fclaudiu19/industrial-gearbox-design/Docs/Glosar relatii OMll.pdf

(1 - acest glosar nu conţine relaţiile de calcul elementare.

GLOSAR

RELAŢII de CALCUL OM II⁽¹

Relaţia | Semnificaţie
mn (z1+ z2) a = 2 cos β | Distanţa dintre axe de referinţă în plan frontal
mn (z1+z2) cos α aw = 2 cos β cos αw | Distanţa dintre axe reală în plan frontal
√da1 2 +√da1 2 −db1 2 −db1 2 −2 aw sin αw εα = 2 π mn cos α | Gardul de acoperire al unui angrenaj cilindric
| Relaţii de calcul a forţelor din angrenajul cilindric cu dantură dreaptă
| Tensiunea maximă normală de contact
1 1 1 1 1 = = ± ± ρ ρ1 ρ2 D1⁄2 D2⁄2 | Curbura redusă
| Factorul de elasticitate
ZN = √ NBH 6 NL | Factorul ciclurilor de solicitare la contact
| Relaţii de calcul a tensiunii maxime de contact din angrenajul cilindric cu dantură dreaptă
| Relaţii de dimensionare a angrenajului cilindric cu dantură dreaptă din condiţia de rezistenţă la contact

Fn =

Ft
cos ∝w

=

2 T1
dw1cos ∝w

| Tensiunile admisibile la contact pentru pinion, respectiv, roată
| Relaţii de calcul a tensiunilor maxime de încovoiere pentru pinion, respectiv, roata angrenajului cilindric cu dantură dreaptă
| Relaţii de dimensionare a angrenajului cilindric cu dantură dreaptă din condiţia de rezistenţă la încovoiere
| Tensiunile admisibile la încovoiere pentru pinion, respectiv, roată
mn = mt cosβ | Dependenţa dintre modulul normal şi cel frontal al unei roţi cilindrice cu dantură înclinată
| Relaţii de calcul a forţelor din angrenajul cilindric cu dantură înclinată
tg αwt = tgαwn/cosβw | Dependenţa dintre unghiul de angrenare în plan frontal şi cel în plan normal al unei roţi cilindrice cu dantură înclinată
Zβ = √cos β | Factorul înclinării danturii pentru solicitarea de contact
| Relaţii de calcul a tensiunii maxime de contact din angrenajul cilindric cu dantură înclinată

Relaţii de dimensionare a angrenajului cilindric cu dantură înclinată din condiţia de rezistenţă la contact

Relaţii de calcul a tensiunilor maxime de încovoiere pentru pinion, respectiv, roata angrenajului cilindric cu dantură înclinată

Relaţii de dimensionare a angrenajului cilindric cu dantură înclinată din condiţia de rezistenţă la încovoiere

Expresia factorului sintetic din relaţiile de mai sus

Parametri geometrici ai roţilor şi angrenajului conic

Raportul de angrenare al angrenajului conic

Forţe în angrenajul conic ortogonal

Relaţii de calcul a tensiunii maxime de contact din angrenajele conice

Relaţii de dimensionare a angrenajelor conice din condiţia de rezistenţă la contact

Relaţii de calcul a tensiunilor maxime de încovoiere din roţile angrenajelor conice

Relaţii de dimensionare a angrenajelor conice din condiţia de rezistenţă la încovoiere

Momentul de torsiune la roata angrenajului hipoid

Raportul de angrenare al angrenajului melcat

Unghiul elicei melcului

Diametrul de divizare al melcului

Forţe în angrenajul melcat

Randamentul angrenajului melcat

Unghiul de frecare redus din angrenajul melcat

Momentul de încovoiere rezultant în secţiunea X

Tensiunea de torsiune secţiunea X

Tensiunea de încovoiere în secţiunea X

Tensiunea echivalentă în secţiunea X (σcX deseori se neglijează)

Tensiunea echivalentă în secţiunea X (torsiune şi încovoiere)

Relaţia de verificare la solicitări compuse (torsiune şi încovoiere)

Momentul echivalent în secţiunea X

Sarcina dinamică echivalentă din rulmenţi

Sarcina dinamică echivalentă medie pentru rulmenţii încărcaţi cu sarcini variabile

Turaţia echivalentă medie a rulmenţilor încărcaţi cu turaţii şi sarcini variabile

Relaţia de calcul a rulmenţilor

Volumul de material rezultat prin uzare

Relaţii de verificare la uzare şi, respectiv, la încălzire a lagărelor cu alunecare cu frecare uscată

Tensiunea de încovoiere din fusul de cap al unui lagăr de alunecare

Ecuaţia de bilanţ termic al unui lagăr cu alunecare cu frecare uscată

Ecuaţia de echilibru a forţelor în direcţie axială din lagărul cu alunecare axial în cazul ipotezei presiunii neuniforme

Ecuaţia de echilibru a forţelor în direcţie axială din lagărul cu alunecare radial în regimul de frecare fluidă

Presiunea medie convenţională din lagărul cu alunecare în regimul cu frecare fluidă

Momentul de frecare din lagărul cu alunecare în regimul cu frecare fluidă

Ecuaţia de bilanţ termic al unui lagăr cu alunecare în regimul cu frecare fluidă

Relaţii de calcul a geometriei transmisiilor prin curele

Forţa utilă transmisă de curea

Relaţii de calcul a forţelor din ramurile unei curele

Forţa din curea generată de forţa centrifugă

Relaţia lui Euler asociată transmisiilor prin curele luând în considerare efectul forţei centrifuge

Coeficientul de frecare redus din transmisiile prin curele trapezoidale

Tensiunea de încovoiere din curea la înfăşurarea pe roţi

Forţa care încarcă arborii transmisiei prin curele

Relaţii de calcul a coeficientului de alunecare elastică

Raportul de transmitere al transmisiei prin curele considerând alunecarea elastică

Numărul mediu de dinţi (activi) în contact cu roţile unei transmisii prin curea dinţată

Tensiunile de încovoiere din cureaua dinţată la înfăşurarea pe roţi

Tensiunea de încovoiere a dintelui unei curele dinţate

Tensiunea de strivire a flancului dintelui unei curele dinţate

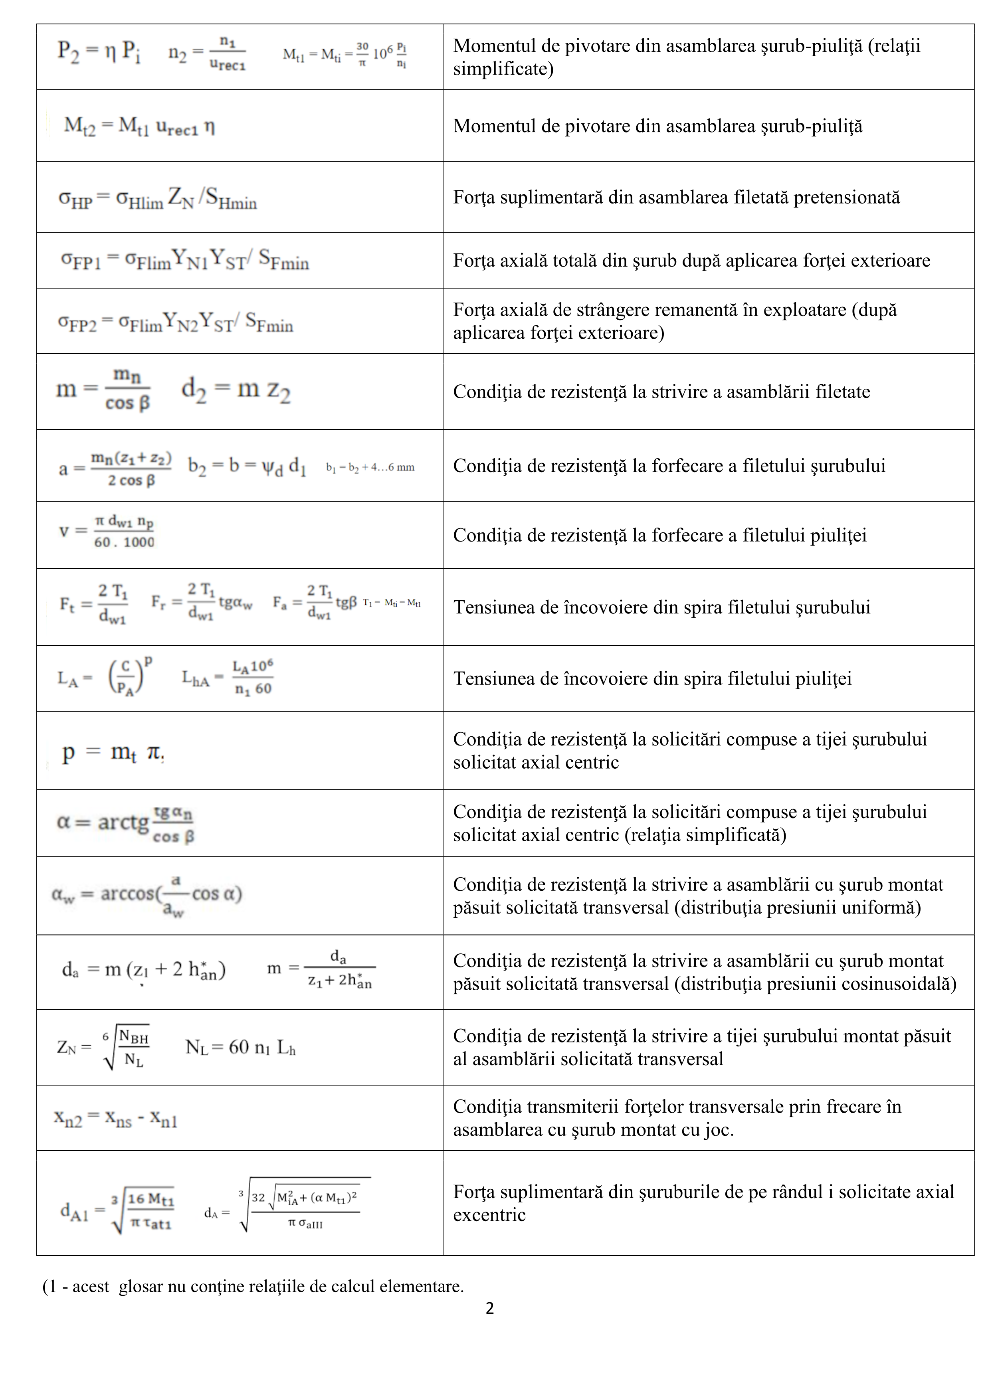
[picture p1: page 8]

concurente sau încrucişate

Forţa normală de calcul la contact a transmisiilor prin fricţiune cu raport de transmitere constant

Gama de reglare

Alunecarea geometrică în cazul variatorului frontal mono

Forţa minimă de apăsare în cazul variatorului frontal mono

Raportul de transmitere instantaneu în cazul variatorului sferic

Raportul de transmitere instantaneu în cazul variatorului toroidal

Relaţia lui Euler pentru variatorul cu conuri deplasabile şi element de împingere
