fclaudiu19/industrial-gearbox-design/Docs/Memoriu Tehnic proiect OM-Fugulin Claudiu.pdf

Fa1

## Departamentul Autovehicule și Transporturi Disciplina Organe de Maşini

# PROIECT DE AN LA DISCIPLINA Organe de Maşini

## Autor: Student Claudiu FUGULIN Programul de studii: Robotică Grupa 4LF822

## Coordonatori: Prof. univ. dr. ing. Gheorghe MOGAN Dr. ing. Eugen BUTILĂ Drd. ing. Diana BUZDUGAN

20…

UNIVERSITATEA TRANSILVANIA DIN BRAŞOV

FACULTATEA DE INGINERIE MECANICĂ

## Disciplina Organe de Maşini

# MEMORIU TEHNIC

## Autor: Student Claudiu Fugulin Grupa 4LF821

## Coordonatori: Prof. univ. dr. ing. Gheorghe MOGAN Dr. ing. Eugen BUTILĂ Drd. ing. Diana BUZDUGAN

20…

## CUPRINS

Prefaţă | 4
1. Aspecte generale şi tema de proiectare | 5
2. Schema structurală şi parametri cinetostatici | 6
3. Predimensionarea angrenajului cilindric | 7
4. Predimensionarea arborilor şi alegerea rulmenţilor | 16
5. Modelarea şi simularea cinematică a mecanismului | 19
6. Verificarea (dimensionarea) angrenajului | 19
7. Forţe în angrenajul cilindric | 24
8. Alegerea şi calculul asamblărilor cu pene paralele | 25
9. Proiectarea formei şi generarea modelelor în CATIA ale parturilor pentru subansamblele
principale | 26
10. Generare subansamble rulmenţi, arbori şi angrenaj | 26
11. Generare subansamble carcase | 29
12. Generare model 3D (ansambu) | 32
13. Verificarea arborilor | 35
14. Verificarea rulmenţilor | 48
15. Modelarea şi generarea desenului de ansamblu | 49
16. Modelarea şi generarea desenelor de execuţie | 50
Bibliografie | 52

ANEXE (aplcaţii în CATIA)
1. Modelul dinților roților nedeplasate în angrenare
2. Modelul angrenajului cilindric cu danturi deplasate şi verificarea continuității angrenării
3. Model pentru simularea cinematică a mecanismului
4. Modelul 3D al reductorului
5. Desenul de ansamblu al reductorului
6. Desene de execuţie

## PREFAȚĂ

Disciplina Organe de mașini este prima disciplină cu caracter aplicativ din programul de pregătire a studenților de la programele de studiu cu profil mecanic prin faptul că implică activități de proiect cu tematici concrete, care se finalizează cu documentație tehnică scrisă și grafică (desen de ansamblu și desene de execuție).
Scopul proiectului la disciplina Organe de maşini este să dezvolte abilităţile practice ale studenţilor de proiectare bazat, pe de-o parte, pe implementarea cunoştinţelor, cu precădere, de Mecanică, Rezistenţa materialelor și Tehnologia materialelor, dobândite în decursul anilor I şi II, pentu calcule de dimensionare şi/sau de verificare, și pe de altă parte, de Desen tehnic, Infografică și Programare pentru reprezentarea grafică a soluțiilor calculate în documente de execuție, montaj, uilizare și chiar de reciclare a viitorului produs. Astfel, aceștia sunt puși în fața faptului de a soluționa în mod independent o lucrare de proiectare, pe baza algoritmilor, metodelor specifice şi pachetelor software avansate din domeniu.
Ca suport pentru derularea activității la proiectul de an la disciplina Organe de maşini s-a utilizat pezentul Îndrumar de proiectare care a fost structurat astfel încât să înlesnească activitatea de instruire a studenților atât pentru a dobândi cunoștințe teoretice cât și abilități practice de lucru cu pachete performante software. Pentru a răspunde, în totalitate, cerințelor impuse prin tema de proiectare este necesar să se urmărească atât etapele de calcul propriu-zis structurate algoritmizat cât și identificarea soluțiilor constructive adecvate, ținând cont și de normle și standardele actuale.
Tematica proiectului privind proiectarea reductoarelor cilindrice s-a adoptat, pe de-o parte, pentru a acoperi aplicativ a cât mai multe cunoștințe prezentate teoretic la curs și, pe de altă parte, ca abilitățile dobăndite de studenți în urma finalizării acestuia să fie suport pentru proiectele ulterioare în cadrul disciplinelor de specialitate.
Deoarece, în ultimul timp, utilizarea calculatorului în activitatea de proiectare s-a consacrat prin apariția de pachete software de calcul, de analiză și de reprezentare grafică laborioase cu interfețe utilizator prietenoase, structura acestei lucrări a fost concepută pentru integrarea în toate etapele de rezolvare a tematicii propuse a tehnologiilor informatice actuale. Această dezvoltare a fost favorizată și de suportul susținut al conducerilor departamentului Autovehicule și Transporturi, facultății de Inginerie Mecanică și Universității Transilvania din Brașov, pe de-o parte, de a achizițione de pachete software performante, chiar și pentru activitatea didactică la nivel de licență și, pe de altă parte, de a asigura săli dotate cu calculatoare performante la nivelul calculator-student. Astfel, în cadrul activităților de proiect și laboartor la disciplina Organe de mașini, și nu numai, s-au dezvoltat și implementat aplicații practice bazate pe pachete software performante actuale (MDESIGN, CATIA, ANSYS). Pentru a facilita lucrul studențiilor cu aceste softuri s-au conceput aplicații de tip ghid care să permită parcurgerea logică a etapelor cu luarea de decizii pe parcurs fără a elimina contribuțiile proprii atât la nivel de concept cât și de detaliu.
Pentru accesarea rapidă a informațiilor necesare privind desfășurarea calculelor precum și pentru documentare privind soluțiile constructive (inclusiv, cele standardizate) și elaborare a documentației finale (memoriu tehnic, desene de anasamblu și de execuție) s-au folosit documente suport integrate într-un algoritm de proiectare predestinat, dar și general, care acoperă mai multe variante de proiectare. Această structurare permite rezolvarea proiectului de fiecare student prin personalizări proprii, favorizat fiind și de exemplele aplicative accesibile ca documente distincte în îndrumarul de proiectare.

Autorul,

## 1. ASPECTE GENERALE ŞI TEMA DE PROIECTARE

### 1.1 Descriere generală a produsului

Reductorul de turaţie este un sistem mecanic demontabil, cu mişcări relative între elemente active (roţi dinţate, arbori, rulmanți) care are ca parametri de intrare, puterea (momentul de torsiune) şi turaţia (viteza unghiulară) arborelui de intrare şi, ca parametri de ieşire, puterea (momentul de torsiune) şi turaţia (viteza unghiulară) arborelui de ieşire.
Pe lângă funcţia principală de transmitere a momentului de torsiune şi mişcării de rotaţie prin angrenajele cu roti dinţate cilindrice se urmăreşte şi îndeplinirea următoarelor funcţii auxiliare: de construcție modulară, de respectarea prevederilor de interschimbabilitate cerute de standardele din domeniu; de respectarea condiţiilor de protecţie a omului şi mediului etc.

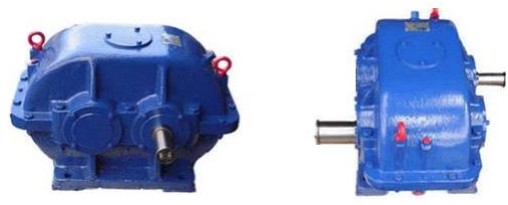
[picture p2: figure]

### 1.2 Obiective și date de proiectare

Obiectivele proiectului
Obiectivul principal
Dobândirea şi dezvoltarea de către studenți de cunoștințe şi abilităţi pentru identificarea, calculul şi proiectarea formei elementelor componente ale transmisiilor mecanice, cu precădere reductoare cilindrice, în vederea execuţiei şi montajului acestora.
Obiective specifice
- dezvoltarea de cunoştinţe fundamentale privind calculul şi proiectarea elementelor transmisiilor mecanice, inclusiv aspecte privind alegerea materialelor şi a tehnologiile de execuţie şi montaj;
- calculul elementelor şi subansamblelor specializate ale transmisiilor mecanice de tip reductor de turaţie cilindric (angrenaj, roţi dinţate, arbori, rulmenţi etc.);
- dezvoltarea de cunoștințe de identificare şi proiectare a formelor elementelor şi subansamblelor transmisiilor mecanice, cu precădere a reductoarelor cilindrice;
- dezvoltarea de abilităţi practice de utilizare a pachetelor performante de calcul (MDESIGN și ANSYS) şi pentru reprezentare grafică (CATIA);
- dezvoltarea de abilităţi practice de elaborare a documentaţiei grafice (modele 3D, desene de ansamblu şi de execuţie);
- dezvoltarea de abilităţi practice de elaborare a documentației scrise (memoriul tehnic).

Date de proiectare
Tema de proiectare a unui produs, de obicei, este lansată de către un beneficiar şi reprezintă o înşiruire de date, cerinţe şi condiţii tehnice care constituie caracteristicile şi performanţele impuse viitorului produs.
În tabelul următor se prezintă datele de proiectare impuse pentru o situaţie practică cerută, unde Pi [kW] reprezintă puterea la intrare, ni [rot/min] - turaţia la intrare, iR - raportul de transmitere al

reductorului, Lh

imp [ore] - durata de funcţionare impusă, PA - planul axelor roţilor angrenajului cilindric:

orizontal (H) sau vertical (V), z1

cil
- numărul de dinţi ai pinionului cilindric.
Pi [kW] | ni [rot/min] | iR | Lh imp [ore] | PA
12.5 | 2500 | 3.5 | 12000 | H | 22
Condiţii de funcţionare şi constructive
Condiţii de funcţionare:
- tipul maşinii (utilajului) în care se integrează: elevator auto sau stand testare frâne;
- tipul încărcării exterioare: alternativă cu şocuri;
- tipul motorului de acţionare: electric, asincron cu rotorul în scurtcircuit;
- nivel de vibraţii şi zgomot, max 25 dB;
- caracteristicile mediului în care funcţioneză: temperaura (- 20 … 60 oC), umiditate max 30 g/m³
;
Condiţii constructive: intrarea și ieşirea pe părți opuse; arborele de ieşire plin.
Condiţii ecologice: utilizarea de materiale şi tehnologii eco, reciclarea materialelor, protecţia vieţii; volum minim; greutate minimă.
Domenii de utilizare
Reductorul de turaţie de proiectat se poate întegra în structurile unor maşini de ridicat şi transportat (de ex. elevatoare pentru ridicarea autoturismelor), instalații de tesatare (de ex. pentru frâne) etc.

## 2. SCHEMA STRUCTURALĂ ŞI PARAMETRI CINETOSTATICI

### 2.1 Schema structurală

Schema structurală funcțional-constructivă
În figură se prezintă schema structurală funcţional-constructivă generală a reductoarelor cilindrice cu o treptă. Din punct de vedere funcţional se evidenţiază următoare părți: angrenaj cilindric cu dantură înclinită; 1

I

– pinion cilindric; 2I
– roată cilindică; A1 – arbore de intrare; A2 – arbore de ieşire; LA

A1
- lagărul A al arborelui A1; LB

A1
- lagărul B al arborelui A1. Din punct de vedere constructiv, reductorul de turaţie formează un ansamblu compus din subansamble şi elemente constructive. Subansamblele sunt structuri independente, care se evidenţiază printr-un grup compact compus, în configuraţie minimală, din cel puţin două elemente constructive sau din alte subansamble şi elemente constructive, în interacţiune permanentă, formate ţinându-se cont, cu precădere, de tehnologiile de montaj, de întreţinere şi de exploatare.
În cazul reductoarelor cilindrice cu o treaptă se definesc următoarele subansamble: SA1 -
subansamblul arborelui de intrare, SA2
- subansamblul arborelui de ieșire, și SC – subansambul carcasă care le susține pe primele două.

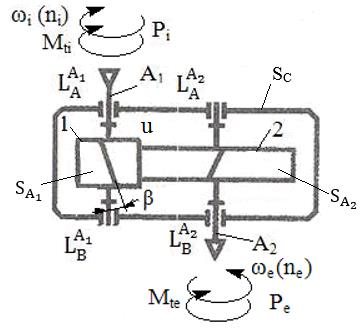
[picture p3: figure]

### 2.2 Parametri cinetostatici

Numere de dinţi şi raportul de angrenare
Considerând valorarea numărului de dinţi ai pinionului cilindric, z1 = z1

cil se determină valoarea
numărului de dinţi ai roţii cilindrice. În tabelul următor se prezintă sintetic aceste valori precum şi abaterea Ab a rapotului de angrenare recalculat faţă de cel de transmitere impus; această abatere respectă limita de max ± 2%.
z1 I | I z2 | urec1 | iR | Ab
22 | 77 | 3.5 | 3.5 | 0%

Puteri, turaţii şi momente de torsiune
Valorile puterilor, turațiilor și momentelor de torsiune la nivelul arborilor reductorului sunt:
Arborele | Puterea [kW] | Turaţia [rot/min] | Momentul de torsiune [Nmm]
Arborele intrare (A1) | P1 = 12.5 | n1 = 2500 | Mt1 = 47746.483
Arborele de ieşire (A2) | P2 =11.875 | n2 = 714.286 | Mt2 = 158757.056
Obs. S-a considerat randamentul angrenajului cilindric, η = 0,95.

## 3. PREDIMENSIONAREA ANGRENAJULUI CILINDRIC

### 3.1 Alegerea oţelului roţilor dinţate, tratamentelor termice şi tehnologiilor

Alegerea tipului oţelului şi tratamentelor termice
Deoarece, Mti = 47746.483Nmm > 30000...40000 Nmm, se adoptă pentru roţile angrenajului oţel de cementare.
Alegerea oţelului, durităţilor şi rezistenţelor
Pentru ambele roţi dinţate se adoptă oţelul, 17MoCrNi14 (0,17% C, aliat cu Molibden, Crom şi Nichel 1,4%) cu caracteristicile mecanice din tabel.
Oţelul | Limita de curgere, σc [MPa] | Rezistenţa la rupere, σr [MPa] | Tratamentul termic de bază | Durităţile flancurilor dinţilor roţilor | Durităţile zonelor interioare ale dinţilor | Tensiunea limită la contact, σHlim [MPa] | Tensiunea limită la încovoiere, σFlim [MPa]
17MoCrNi1 4 | 650 | 850 | Cementare | HRC1,2 = 55 | HB1,2 = 280 | 1402,5 | 400

Procedee de prelucrare a danturilor roților cilindrice
Corespunzător tipului oţelului şi tratamentului termic adoptate se impune prelucrarea prin mortezare înainte de cementare şi prin rectificare după călire şi revenre.

### 3.2 Predimensionarea angrenajului cilindric

Determinarea modulului frontal al danturilor roților cilindrice
În figură se prezintă schema parametrilor principali de calcul a angrenajului cilindric în care se evidenţiază momentul de torsiune al pinionului (T1) şi parametri geometrici principali de calcul: diametrul de divizare al pinionului (d1), diametrul de divizare al roţii (d2), lăţimea danturii (b), distanţa dintre axe de referinţă (a), unghiul de înclinare a danturii (β).

Date de intrare

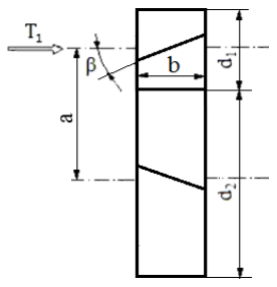
[picture p4: figure]

În tabelul următor sunt sintetizate valorile parametrilor de calcul cunoscuţi.
Denumirea parametrului | Simbolul | Valoarea | Unitatea de măsură
Raportul de angrenare | u | 3.5 | -
Numărul de dinţi al pinionului | z1 | 22 | -
Momentul de torsiune al pinionului | T1 | 47746.483 | Nmm
Turaţia pinionului conic | np | 2500 | rot/min
Durata de funcţionare impusă | Lh imp | 12000 | ore
Tensiunea limită la oboseala de contact, | σHlim | 1402,5 | MPa
Tensiunea limită la oboseala încovoiere, | σFlim | 400 | MPa
Unghiul de înclinare a danturii | β | 10 | o (grade)

Calculul modulului frontal din solicitarea de contact
Valoarea modului exterior din solicitarea de contact se determină cu relaţia,

,

conform datelor următoare:

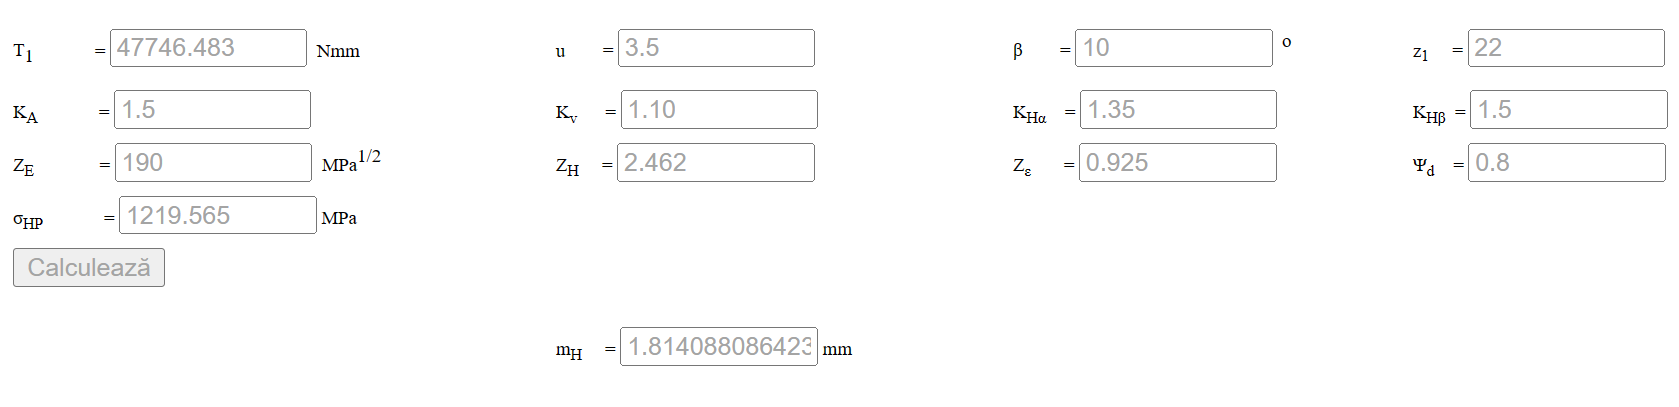
[picture p5: figure]

unde, T1 reprezintă momentul de torsiune al pinionului (Mt1), u - raportul de angrenare, β - unghiul de înclinare a danturii, z1 - numărul de dinţi ai pinionului cilindric, KA - factorul regimului de funcţionare, Kv - factorul dinamic, KHα - factorul repartizării neuniforme a sarcinii pe perechile de dinţi aflate în angrenare pentru solicitarea de contact, KHβ - factorul repartizării neuniforme a sarcinii pe lungimea dintelui pentru solicitarea de contact, ZE - factorul de elasticitate a materialelor roţilor, ZH - factorul zonei de contact, Zε - factorul gradului de acoperire pentru solicitarea de contact, ψd = b/d1 - factorul de lăţime, σHP - tensiunea admisibilă la solicitarea de contact.

Calculul modulului frontal exterior din solicitarea de încovoiere
Valoarea modului frontal din solicitarea de încovoiere se determină cu relaţia,

,

conform datelor următoare:

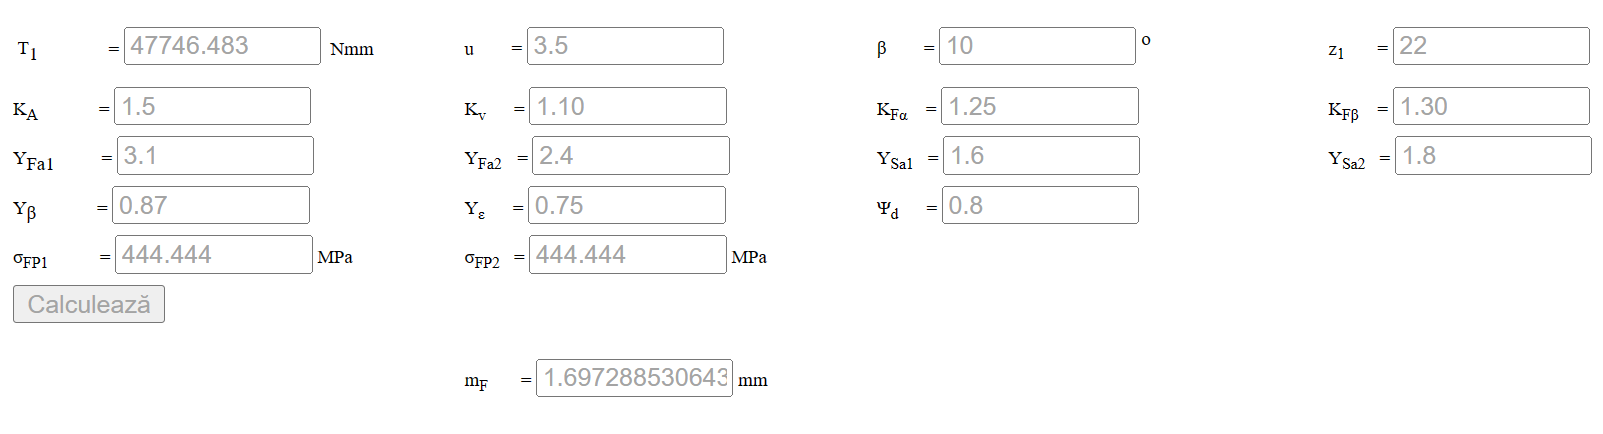
[picture p6: figure]

unde, T1 reprezintă momentul de torsiune al pinionului (Mt1), u - raportul de angrenare, β - unghiul de înclinare a danturii, z1 - numărul de dinţi al pinionului cilindric, KA - factorul regimului de funcţionare, Kv - factorul dinamic, KFα - factorul repartizării neuniforme a sarcinii pe perechile de dinţi aflate în angrenare pentru solicitarea de încovoiere, KFβ - factorul repartizării neuniforme a sarcinii pe lungimea dintelui pentru solicitarea de încovoiere, YFa1 - factorul de formă a dinţilor pinionului cilindric, YFa2 -factorul de formă a dinţilor roţii cilindrice, YSa1 - factorul de corecţie a tensiunii la baza dinţilor pinionului cilindric, YSa2 - factorul de corecţie a tensiunii la baza dinţilor roţii cilindrice, Yβ - factorul înclinării dinţilor, Yε - factorul gradului de acoperire pentru solicitarea de încovoiere, ψd = b/d1 - factorul de lăţime, σFP1 - tensiunea admisibilă la solicitarea de încovoiere pentru pinion, σFP2 - tensiunea admisibilă la solicitarea de încovoiere pentru roată.

Modulul frontal calculat
Ţinând cont de valorile modului frontal exterior obţinute din calculele la solicitările de contact şi de încovoiere rezultă,

mc = max (mH, mF) = max (1.814; 1.697) = 1.8 mm.

Astfel, se evidenţiază că solicitarea de contact este solicitarea principală.

Standardizarea modulului normal şi parametri geometrici principali
Ca urmare a standardizării modulului normal se pot determina parametri principali ai angrenajului cilindric.
Parametrul | Simbolul | Valoarea [mm] | Observaţii
Modulul frontal calculat | mc | 1.814
Modulul normal calculat | mnc = mc cos β | 1.697
Modulul normal (standardizat) | mn | 2.5
Modulul frontal | mn m = cosβ | 2.539
Diametrul de divizare al pinonului | d1 = m z1 | 55.853 | a = (d1 + d2)/2, 125.659 = (55.853+195.503)/2 (se verifică)
Diametrul de divizare al roţii | d2 = m z2 | 195.503
Distanţa dintre axe de referinţă | mn(z1+ z2 ) a = 2 cosβ | 125.659
Lăţimea danturii roţii | b2 = b = ψd d1 | 44.686(APROX44)
Lăţimea danturii pinionului | b1 = b2 + 4…6 | 48.686(APROX48)

Modelarea profilelor dinţilor roţilor nedeplasate în angrenare (CATIA)

Personalizarea datelor de intrare
Simbol teoretic | Semnificaţia
αn | o Unghiul de presiune (angrenare) normal [ ]
han ∗ | Coeficientul înălţimii capului dintelui
c0n ∗ | Coeficientul jocului la piciorul dintelui
∗ ρn | Coeficientul razei de racordare
z1 | Numărul de dinţi ai pinionului
z2 | Numărul de dinţi ai roţii
mn | Modulul normal [mm]
β | Unghiul de înclinare a danturii [ o ]
aw | Distanţa dintre axe (reală) [mm]
xn1 | Coeficientul deplasării de profil a danturii pinionului (zero, roţi nedeplasate)
g | Grosimea coroanei [mm]

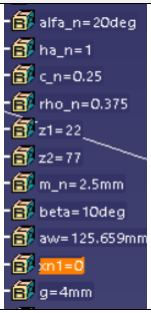
[picture p7: figure]

Verificarea modelului CATIA Ai ramas aici
Simbol teoretic | Semnificaţia | Verificare

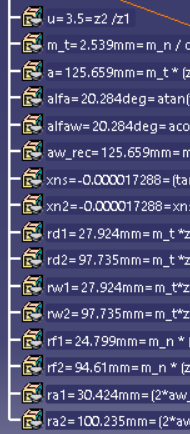
[picture p8: figure]

u | Raportul de angrenare | u >1; 3.5 > 1
m | Modulul frontal [mm] | m > mn; 2,539 > 2
a | Distanţa dintre axe de referinţă [mm] | a = aw ; 125.659 = 125.659
α | o ] Unghiul de presiune frontal [ | α > αn; 20,284 > 20
αw | o ] Unghiul de angrenare frontal [ | αw = α; 20,284 = 20,284
aw | Distanţa dintre axe reală [mm] | aw (aw_rec) = a 125.659 = 125.659
xns | Suma coeficeienţilor depasărilor | xns = 0
xn2 | Coeficientul deplasării roţii | xn2 = 0
rd1 | Raza cercului de divizare al pinionului [mm] | rd1+ rd2 = a 27.924+97.735=125.659
rd2 | Raza cercului de divizare al roţii [mm]
rw1 | Raza cercului de rostogolire al pinionului [mm] | rw1 = rd1; 27.924= 27.924
rw2 | Raza cercului de rostogolire al roţii [mm] | rw2 = rd2; 97.735= 97.735
rf1 | Raza cercului de picior al pinionului [mm] | rf1 < rd1; 24.799 < 27.924
rf2 | Raza cercului de picior al roţii [mm] | rf2 < rd2 ; 94.61< 97.735
ra1 | Raza cercului de divizare al pinionului [mm] | ra1 > rd1; 30.424 > 27.924
ra2 | Raza cercului de divizare al roţii [mm] | ra2 > rd2; 100.235 > 97.735

Modelul CATIA
`

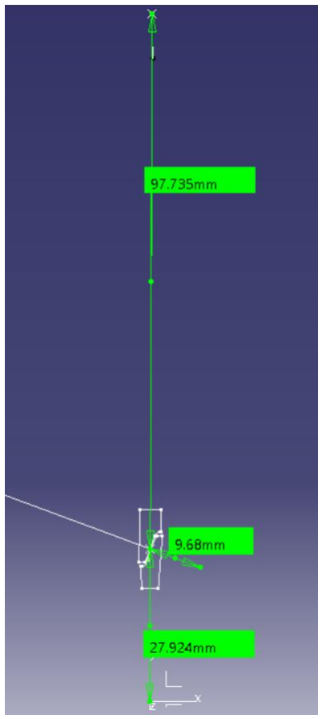
[picture p9: figure]

Standardizarea distanţei dintre axe şi parametri geometrici principali
Alegerea (standardizarea) distanţei dintre axe
Pentru distanţa dintre axe standard, aw = 125 mm, restricţiile impuse în vederea realizării angrenajului cu distanţa dintre axe impusă, - 0,5mn < aw – a ≤ mn devin:

-0,5 * 2.5 < 125-125.659 = -1.25< -0.659 ≤ 2.5 (se verifică).

Determinarea parametrilor geometrici principali ai angrenajului deplasat
Denumirea parametrului | Relaţia de calcul | Valoarea | Unitatea de măsură | Observaţii
Unghiul de presiune frontal | | 20.283 | [ o ] | αn = 20o
Unghiul de angrenare frontal | | 19.449 | o [ ]
Suma coeficienţi depasărilor de | | -0.258

profil ale danturilor roţilor

Coeficientul deplasării de profil a danturii pinionului | +0.1494(se adopta 0 conform observatiilor) | xn2 = -0.407

Pentru asigurarea distanţei dintre axe impusă (aw = 125 mm) şi a unor rezistențe mărite la contact și încovoiere, în continuare, se vor considera următoarele valori:

Numărul de dinţi ai pinionului, z1 | Numărul de dinţi ai roţii, z2 | Coeficientul deplasării de profil a danturii pinionului, xn1 | Coeficientul deplasării de profil a danturii roţii, xn2 | Raportul de angrenare recalaculat, urec2
22 | 77 | 0 | -0.407 | 3.5
Obs. Abaterea raportului de angrenare recalculate (urec2) față de cel de transmitere impus (iR), Ab = +0%.

Modelarea şi verificarea angrenajului deplasat (CATIA)
MODIFICA PANA LA CAPITOLUL 4
Date de intrare
αn | Unghiul de presiune (angrenare) normal [ o ]
∗ han | Coeficientul înălţimii capului dintelui
∗ c0n | Coeficientul jocului la piciorul dintelui
ρn ∗ | Coeficientul razei de racordare
z1 | Numărul de dinţi ai pinionului (modificat)
z2 | Numărul de dinţi ai roţii (modificat)
mn | Modulul normal [mm]
β | o Unghiul de înclinare a danturii [ ]
aw | Distanţa dintre axe reală [mm]
xn1 | Coeficientul deplasării de profil a danturii pinionului (calculat)
g | Grosimea coroanei [mm]

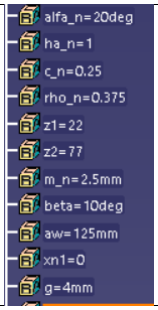
[picture p10: figure]

Verificarea modelului
Simbol teoretic | Semnificaţia | Verificare
u | Raportul de angrenare | u = urec2; 3.5 = 3.5
m | Modulul frontal [mm] | m > mn; 2.539 > 2.5
a | Distanţa dintre axe de referinţă [mm] | a > aw ; 125.659 > 125
α | o Unghiul de presiune frontal [ ] | α > αw, 20.284 > 19,45 (angr. Minus)
αw | Unghiul de angrenare fronatl [ o ]
aw | Distanţa dintre axe reală [mm] (verificare) | aw > a; 125 > 125.659 (angr. Minus)
xns | Suma coeficeienţilor depasărilor | xns = 0; 0 = 0 (angr.zero
x | Coeficientul deplasării roţii | deplasat ) n2
rd1 | Raza cercului de divizare al pinionului [mm] | rw1,2 > rd1,2 (angr. Minus) 27.778>27.924; 97.222>97.735 rd1+ rd2 = a; 27.924+97.735=125.659 rw1+ rw2 = aw 27.778+ 97.222=125
rd2 | Raza cercului de divizare al roţii [mm]
rw1 | Raza cercului de rostogolire al pinionului [mm]
rw2 | Raza cercului de rostogolire al roţii [mm]
rf1 | Raza cercului de picior al pinionului [mm] | rf1 < rw1; 24.799 < 27.778
rf2 | Raza cercului de picior al roţii [mm] | rf2 < rw2; 93.964 < 97.222
ra1 | Raza cercului de divizare al pinionului [mm] | ra1 > rw1; 30.411 > 27.778
ra2 | Raza cercului de divizare al roţii [mm] | ra2 > rw2; 99.576 > 97.222

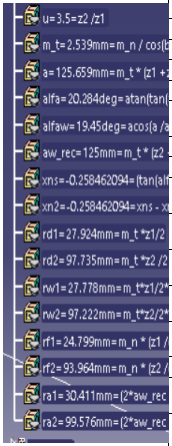
[picture p11: figure]

Modelul CATIA

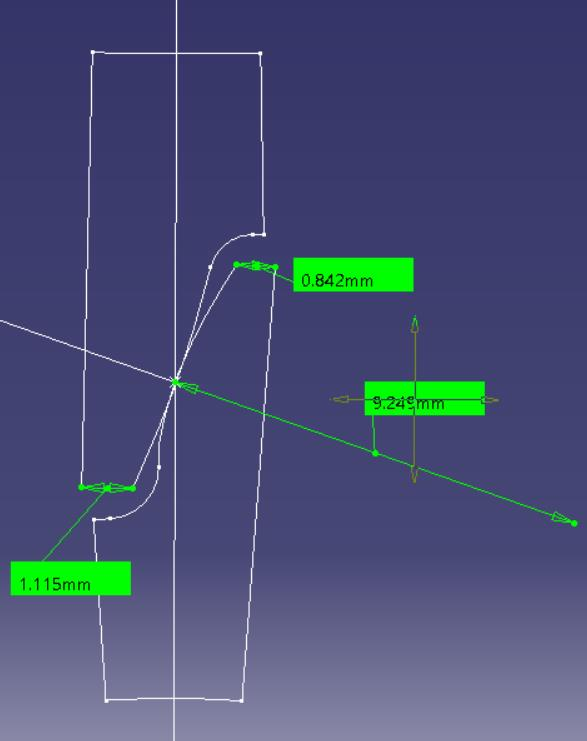
[picture p12: figure]

Verificarea ascuţirii dinţilor roţilor

În urma măsurării pe modelul CATIA, s1 = 0.567 mm şi s2 = 1.165 mm (v. figura de mai sus). Verificare: s1,2 > (0, 3…0,45) mn/2; 0.567 > 0.375 mm (se verifică).

Simularea şi verificarea continuității angrenării (CATIA)

Date de intrare
Simbol teoretic | Semnificaţia
αn | o Unghiul de presiune (angrenare) normal [ ]
∗ han | Coeficientul înălţimii capului dintelui
c0n ∗ | Coeficientul jocului la piciorul dintelui
∗ ρn | Coeficientul razei de racordare
z1 | Numărul de dinţi ai pinionului
z2 | Numărul de dinţi ai roţii
mn | Modulul normal [mm]
β | Unghiul de înclinare a danturii [ o ]
aw | Distanţa dintre axe reală [mm]
xn1 | Coeficientul deplasării de profil a danturii pinionului
g | Grosimea coroanei [mm]
Unghiul de rotire a dinţilor pinionului pentru simulare [

o
]

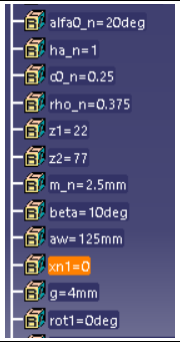
[picture p13: figure]

Modelul CATIA

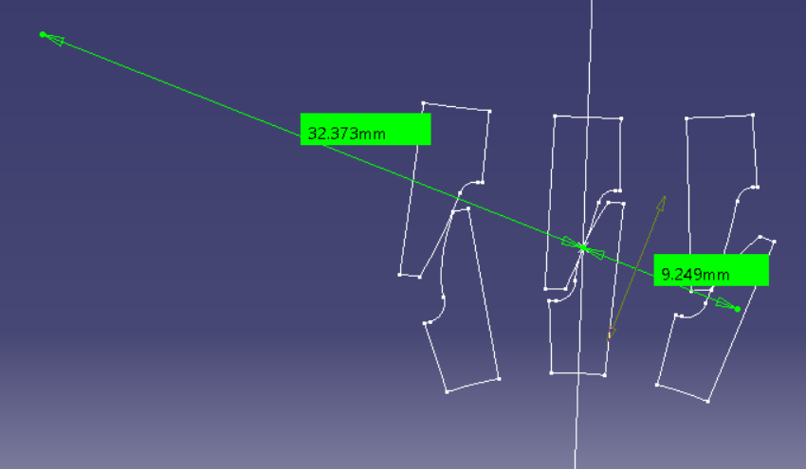
[picture p14: figure]

Simularea angrenării şi verificarea continuităţii Poziţii limită ale perechilor de dinţi în angrenare:

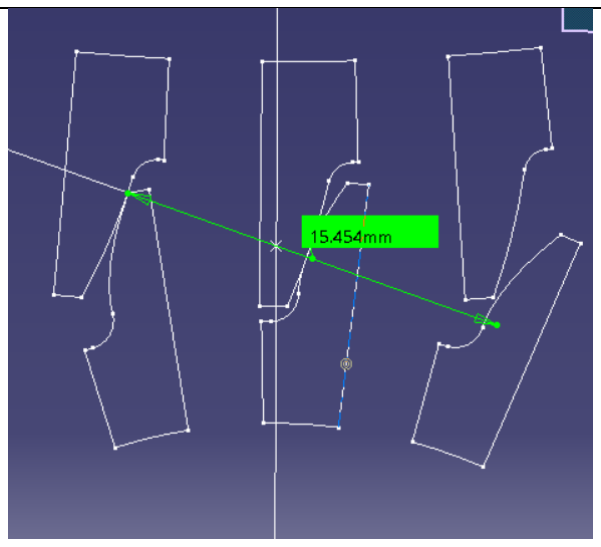
[picture p15: figure]
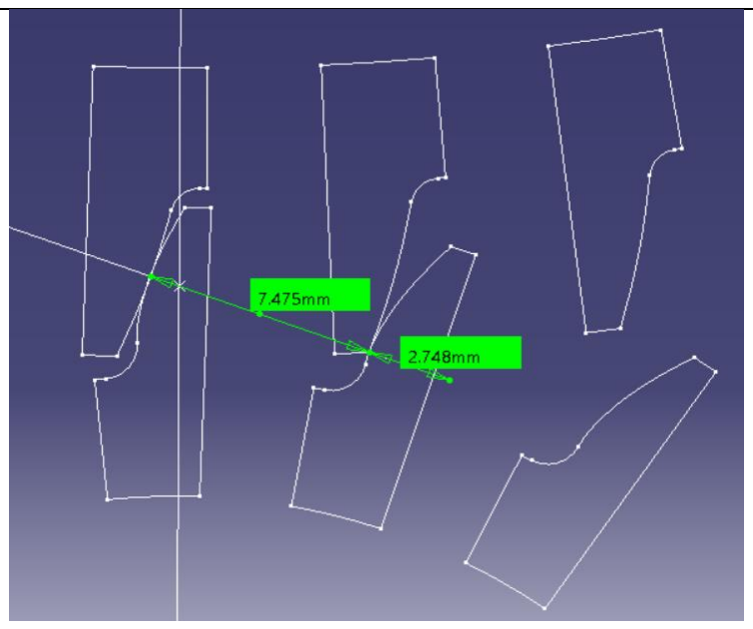
[picture p16: figure]

Intrarea în angrenare a perechii de dinţi n; T1A =2.748, mm, pb = 7.475 mm | Ieşirea din angrenare a perechii de dinţi n+1; T1B = 15.454 mm

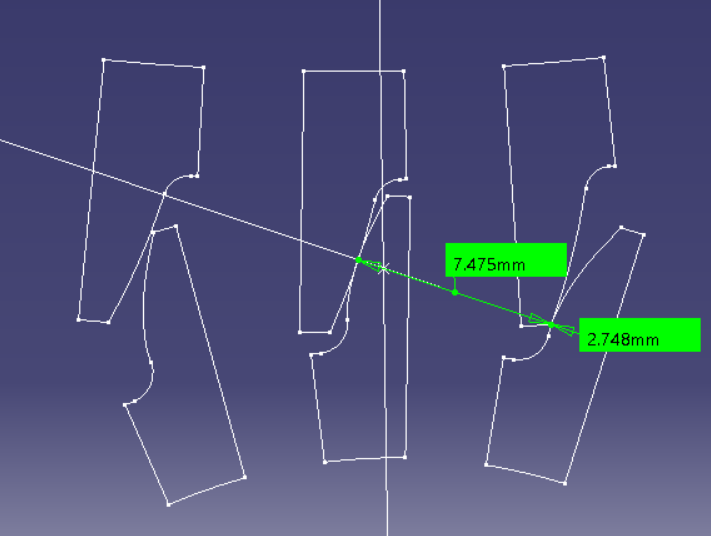
[picture p17: figure]
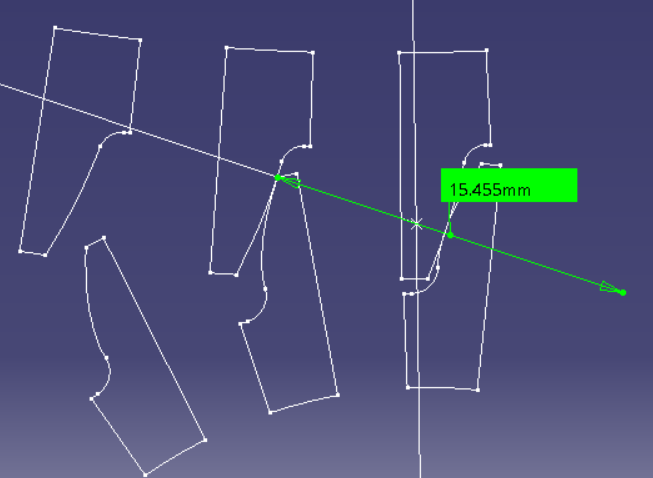
[picture p18: figure]

Intrarea în angrenare perechii de dinţi n-1; T1A = 2.748 mm, pb = 7.475mm | Ieşirea din angrenare a perechii de dinţi n; T1B = 15.455mm

Determinarea valorii aproximative a gradului de acoperire frontal prin măsurare

εα

m =

AB
Pb

=

T1B−T1A
pb

= =

15.455−2.748
7.475

= 1.699.

Valorile numerice sunt obţinute prin măsurare de cel puţin două ori, conform tebelului de mai sus; în această relaţia s-au considerat mediile aritmetice ale valorilor măsurate.

Determinarea valorii exacte a gradului de acoperire frontal
Din modelul CATIA rezultă,

Abaterea valorii gradului de acoperire obţinut prin măsurare, εα m = 1.699, în raport cu gradul de acoperire calculat, εα = 1,698, Ab = +0.094%.

## 4. PREDIMENSIONAREA ARBORILOR ŞI ALEGEREA RULMENŢILOR

### 4.1 Structuri constructive ale subansamblelor arborilor

Subansamble arbori de intrare şi de ieşire

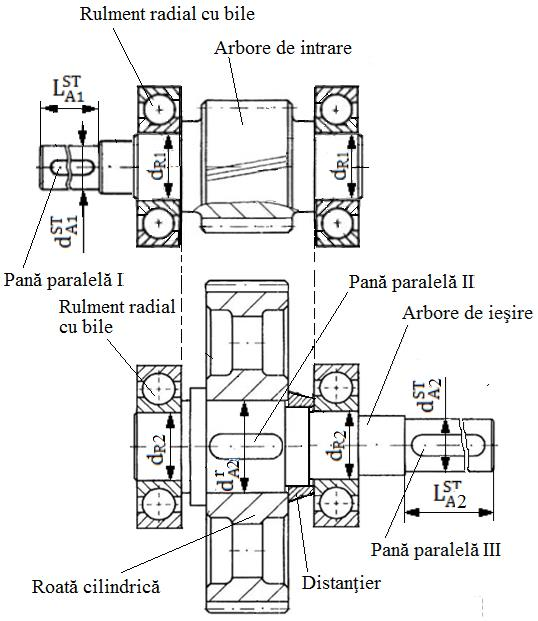
[picture p19: figure]

Semnificaţii notații
dA1

ST
– diametrul capului arborelui de intrare (standardizat), LA1

ST
– lungimea capului arborelui de intrare (standardizată), dA2

ST
– diametrul capului arborelui de ieşire (standardizat), LA2

ST
– lungimea capului
arborelui de ieşire (standardizată), dR1 – diametrul interior al rulmenţilor arborelui de intrare, dR2 – diametrul interior al rulmenţilor arborelui de ieşire. ), dA2

r
– diametrul tronsonului arborelui de ieşire de sub roata cilindrică.

### 4.2 Predimensionarea arborilor

Alegerea materialelor arborilor şi tratamentelor termice
Caracteristici şi tratamente termice:
Oţelul | Limita la curgere/rupe re [MPa] | Tensiunea admisibilă la încovoiere [MPa] | Tratamentul termic | Duritatea la suprafaţă | Duritatea
| | simetrică
Marca | σc/σr | σaiI | σaiII | σaiIII | Îmbunătăţire/ Cementare | HB/HRC | HB
în interior Statică | Pulsatorie | Alternant

Arborele de intrare (corp comun cu pinionul cilindric)
17MoCrNi14 | 650/850 | 270 | 130 | 75 | Cementare | 55…63 HRC | 280…320
Arborele de ieşire
C45 | 600/800 | 200 | 95 | 55 | Îmbunătăţire | 250…300
| | | | | | HB | 250…300

Calculul de predimensionare a arborilor
Diametrele capetelor arborilor de intrare și de ieșire se determină cu relaţia,

dAi = √
16 Mti

π τati

,

unde, considerând i = 1, 2, dA1 reprezintă diametrul arborelui de intrare, dA2 - diametrul arborelui de ieşire, Mt1 – momentul de torsiune al arborelui de intrare, Mt2 – momentul de torsiune al arborelui de ieşire, τat1 – tensiunea admisibilă la torsiune a materialului arborelui de intrare, τat2 – tensiunea admisibilă la torsiune a materialului arborelui de de ieşire.
Valorile parametrilor de calcul:
Parametrul | Arbore de intrare (A1) | Arbore de ieşire (A3)
Momentul de torsiune | Mt1 = 47746.483 Nmm | Mt2 = 158757.056 Nmm
Tensiunea admisibilă | τat1 = 20 MPa | τat2 = 30 MPa
Diametrul | dA1 = 22.994 mm | dA2 = 29.982 mm

Obs. Valorile diametrelor se vor rotunji.

Standardizarea capetelor arborilor de intrare/ieşire Formă şi dimensiuni

Valorile parametrilor:
Denumire parametru | Arbore de intrare (A1) | Arbore de ieşire (A2)
Diametrul standard | dA1 ST = 22 mm | dA2 ST = 30 mm
Lungimea standard | LA1 ST = 36 mm | LA2 ST = 58 mm

Obs. S-au adoptat capete de arbori cu lungime scurtă.

### 4.3 Alegerea rulmenţilor şi montajelor

Alegerea rulmenţilor
Din considerente de încîrcare a rulmenților cu forte radiale medii și axiale mici se adoptă rulmenți radiali.
Date despre rulmenţi:
Arborele | Tipul rulmentului | Simbol | Dimensiuni [mm] | Capacitatea dinamică
| D | B | T | a | C [N] d
De intrare | Radial cu bile | 6207 | 30 | 62 | 16 | - | - | 19300
De ieşire | Radial cu bile | 6208 | 40 | 80 | 18 | - | - | 29000

Obs.
- diametrele tronsoanelor pe care se montează rulmenţii: dR1 = 30 mm, dR2 = 40 mm;
- pentru arborele de ieşire se adoptă diametrul tronsonului pe care se montează roata cilindrică,
dA2

r
= dR2 + 10 mm = 50 mm.

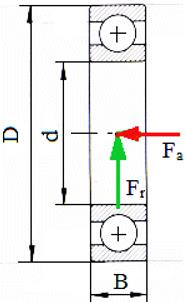
[picture p20: figure]

Alegerea montajelor rulmenţilor Arbore de intrare

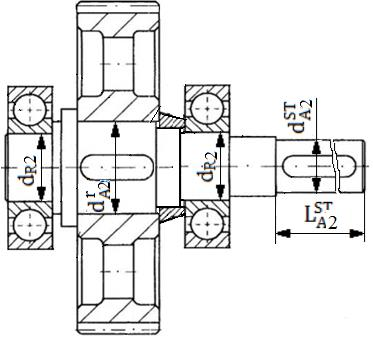
[picture p21: figure]

Arbore de ieşire

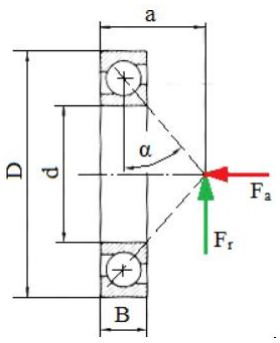
[picture p22: figure]
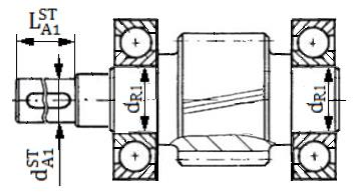
[picture p23: figure]

## 5. MODELAREA ŞI SIMULAREA CINEMATICĂ A MECANISMULUI(MODIFICA)

### 5.1 Generarea și simularea modelului cinematic (CATIA)

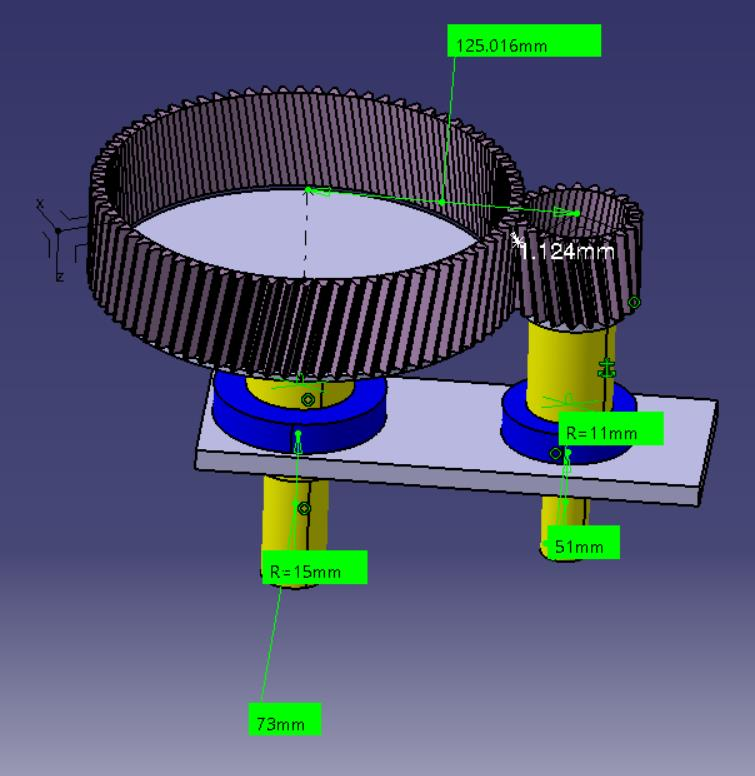
[picture p24: figure]

## 6. VERIFICAREA (DIMENSIONAREA) ANGRENAJULUI(MODIFICA)

### 6.1 Geometria angrenajului și roților cilindrice

Parametri geometrici

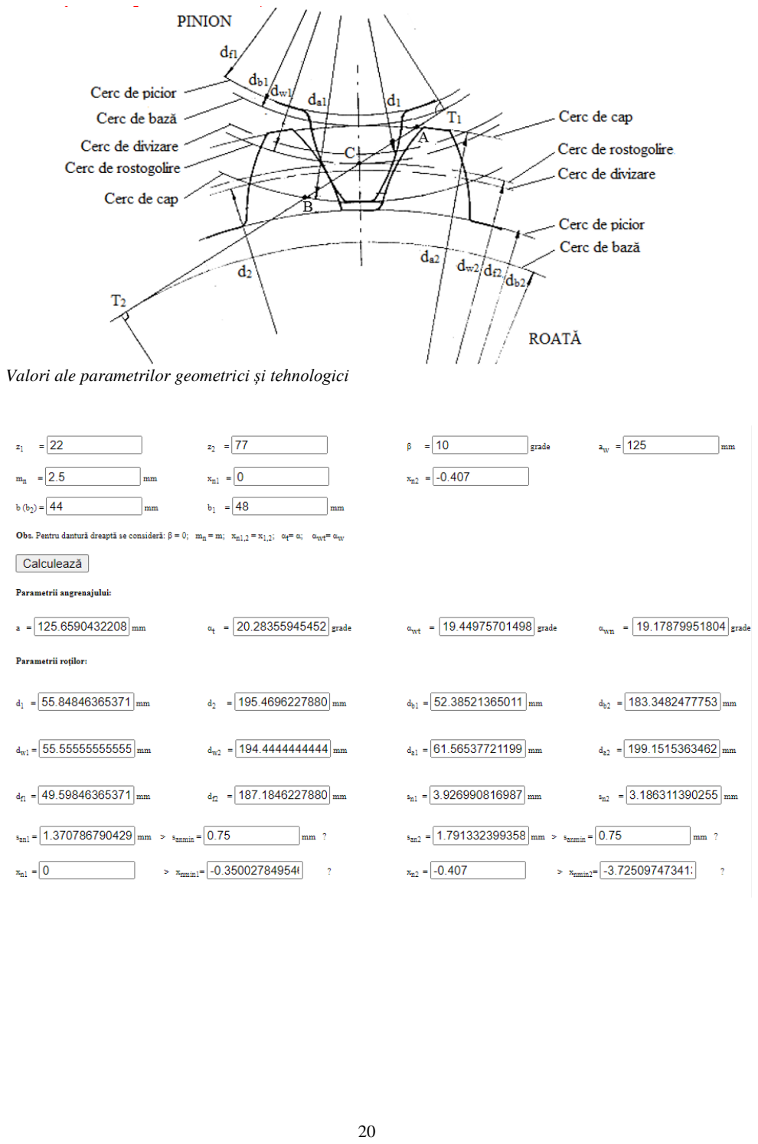
[picture p25: page 20]

Valori ale parametrilor geometrici și tehnologici

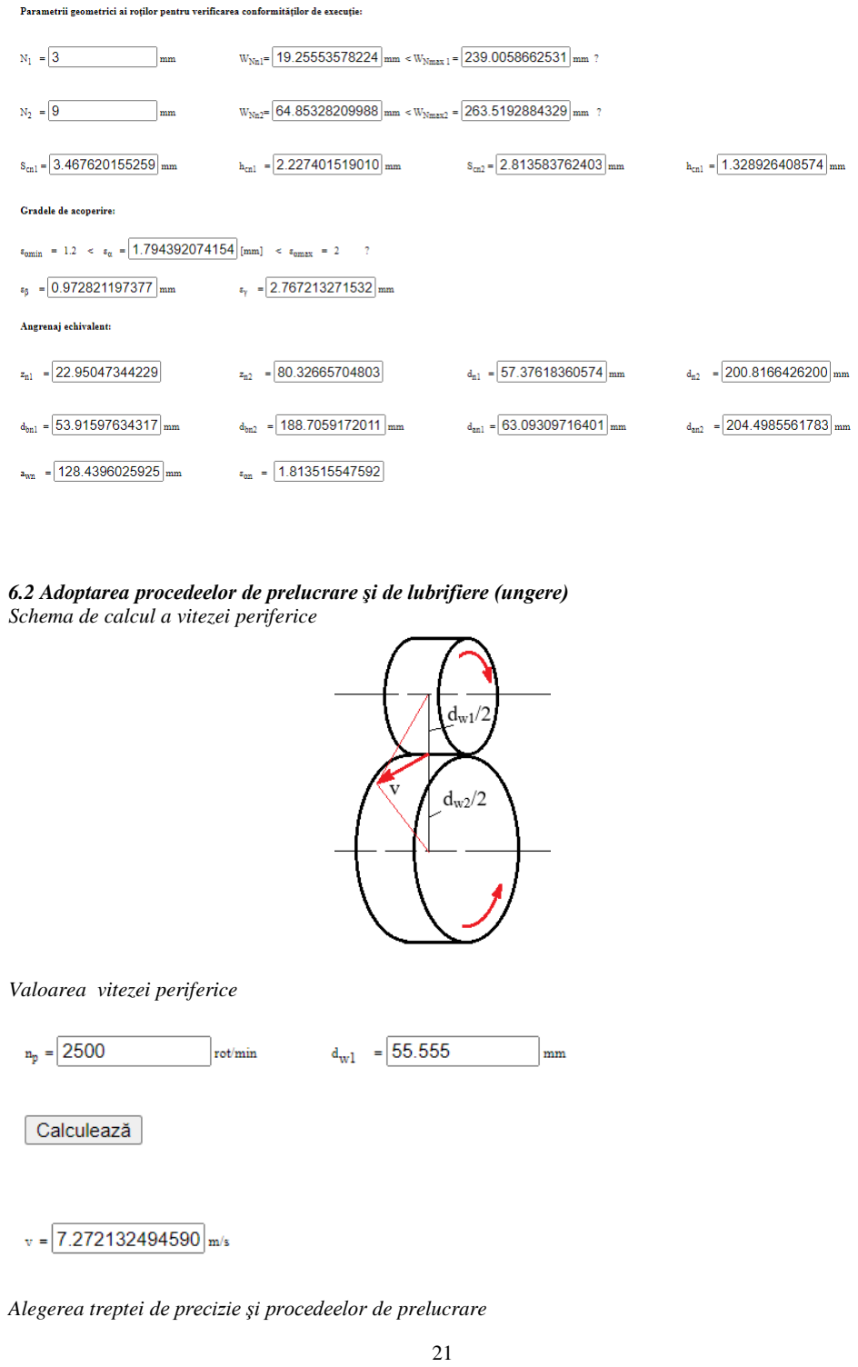
[picture p26: page 21]

### 6.2 Adoptarea procedeelor de prelucrare şi de lubrifiere (ungere)

Schema de calcul a vitezei periferice

Valoarea vitezei periferice

Alegerea treptei de precizie şi procedeelor de prelucrare

Tipul danturii cilindrice | Treapta de precizie | Procedeul de prelucrare
Înclinată | 8 | Frezare grosolană (înainte de cementare) + rectificare (după cementare şi călire)

Alegerea rugozităţilor
Tipul danturii cilindrice | Rugozitatea flancului, Ra_f [μm] | Rugozitatea racordării, Ra_r [μm] | Procedeul de prelucrare final
Înclinată | 0,8 | 1,6 | Rectificare grosolană

Alegerea tipului lubrifiantului (uleiului) şi vâscozităţii acestuia
Din considerente legate de cinematică și restricțiile de mediu se adoptă ulei de transmisii, TIN 120 EP.

### 6.5 Parametri de executie şi montaj ai angrenajului şi roţilor dinţate

Jocuri, abateri şi toleranţe ale angrenajului şi roţilor cilindrice Jocului minim necesar, jmin

nec = (0,01…0,03) mn = (0,01…0,03) 2.5 = (0,025…0,075) mm; se adoptă 0,05 mm (50 μm).
Jocul minim normal, jnmin = 140 μm;
Tipul ajustajului, C.
Tipul toleranţei jocului dintre flancuri, c;
Toleranţele bătăii radiale: Fr = 45 μm, pentru pinion; = 63 μm, pentru roată.
Abatererile minime ale cotelor peste dinţi: Ews = 60 μm, pentru pinion; Ews = 100 μm, pentru roată. Toleranţele cotelor peste dinţi: Tw = 50 μm, pentru pinion; Tw = 70 μm, pentru roată.
Abatererile minime ale grosimilor dinţilor pe coarde constante: Ecs = 70 μm, pentru pinion; Ecs = 100 μm, pentru roată.
Toleranţele grosimii dintelui pe coarda constantă: Tc = 90 μm, pentru pinion; Tc = 140 μm, pentru roată.
Abaterile limită ale distanţei dintre axe, fa = ±45 μm.

Personalizarea toleranțelor angrenajului şi roţilor ((WNn)−EWs−TW

−EWs | ; (s̅cn)−Ecs−Tc
−Ecs | ; aw ±fa):
- cota peste 3 dinţi, 19.770−0,11

−0,06 şi coarda constantă, 4.01−0,16

−0,07, la înălţimea hcn = 2.575 mm, pentru pinion;
- cota peste 9 dinţi, 42.655−0,15

−0,08 şi coarda constantă, 3.688−0,23

−0,09, la înălţimea hcn = 2.11 mm, pentru

roată;
- distanţa dintre axe, 90 ±0,045 mm.

## 7. FORŢE ÎN ANGRENAJUL CILINDRIC(MODIFICA)

### 7.1 Schema forţelor din angrenajul cilindric RCil H

Direcţiile şi sensurile forţelor
Forţa tangenţială: direcţie tangentă la cercurile de rostogolire; sensul opus vitezei (forţă rezistentă), pentru roata conducătoare, şi acelaşi sens cu viteza (forţă motoare), pentru roata condusă.
Forţa radială: direcţie radială; sensul spre centrul roţii.
Forţa axială: direcţie axială; sensul determinat de direcţia de înclinare a dintelui şi de sensul de rotaţie al roţii.

Schema forţelor

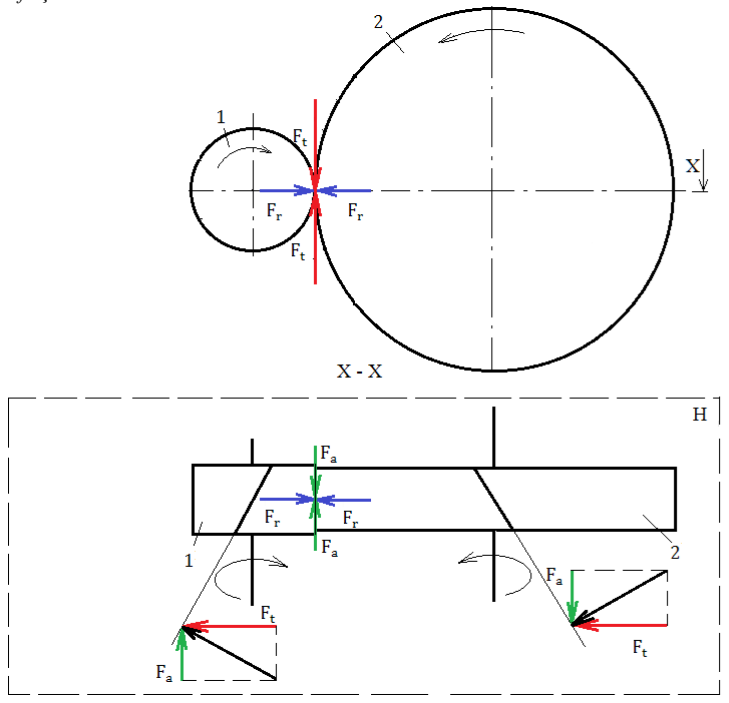
[picture p27: figure]

Semnificaţiile notaţiilor:
Elemente structurale: angrenaj cilindric cu, 1 – pinion cilindric, 2 – roată cilindrică. Forţe în angrenajul cilindric: Ft – forţa tangenţială; Fr – forţa radială; Fa – forţa axială.

### 7.2 Schema forţelor din angrenajul RCil V

Direcţiile şi sensurile forţelor
Forţa tangenţială: direcţie tangentă la cercurile de rostogolire; sensul opus vitezei (forţă rezistentă), pentru roata conducătoare, şi acelaşi sens cu viteza (forţă motoare), pentru roata condusă.
Forţa radială: direcţie radială; sensul spre centrul roţii.
Forţa axială: direcţie axială; sensul determinat de direcţia de înclinare a dintelui şi de sensul de rotaţie al roţii.

Schema forţelor

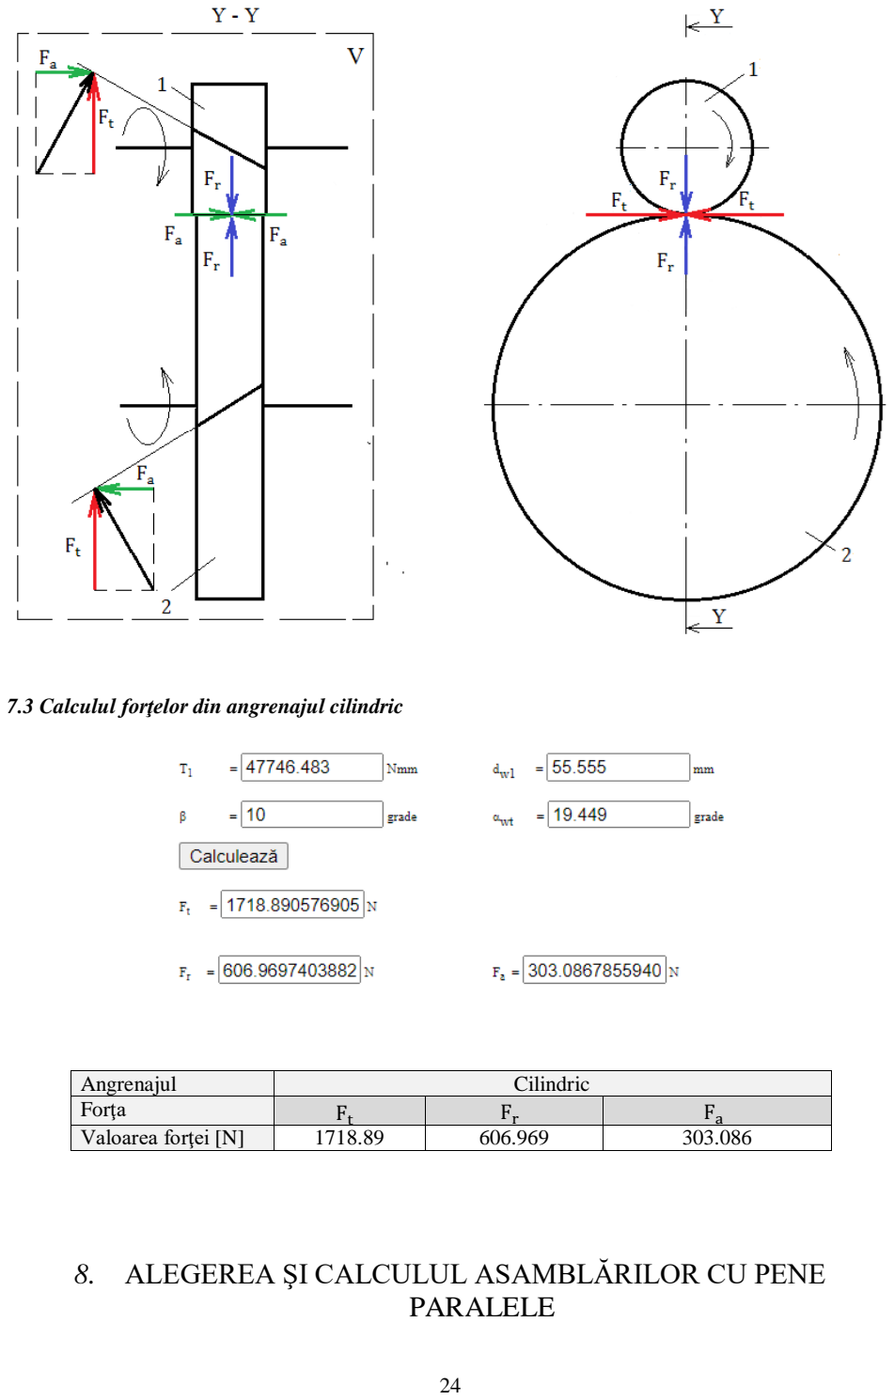
[picture p28: page 24]

### 7.3 Calculul forţelor din angrenajul cilindric

Angrenajul | Cilindric
Forţa | Ft | Fr | Fa
Valoarea forţei [N] | 1718.89 | 606.969 | 303.086

## 8. ALEGEREA ŞI CALCULUL ASAMBLĂRILOR CU PENE PARALELE

## 8.1 Alegerea materialului, formelor şi dimensiunilor penelor paralele

Materialul penelor
Pentru toate penele se adoptă oțel pentru construcții mecanice E295 cu limita de curgere σ02 = 295 MPa, tensiunea admisibilă la strivire σas = 70…120 MPa, tensiunea admisibilă la forfecare τaf = 60…80 MPa.

Tipurile şi formelor penelor paralele

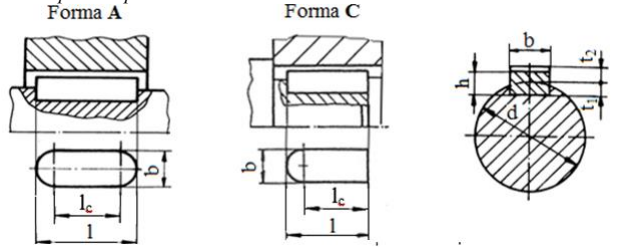
[picture p29: figure]

### 8.2 Calculul asamblărilor cu pene paralele

Parametri de calcul şi valori

lc [mm](recalculate)=17 cu formula: lc = l_stas - b, lc = 21 | lc = 20
Pentru penele I şi III, deoarece lc < LA1,2, se adoptă o câte o pană, iar pentru pana II, deoarece lc < Lb, se adoptă, de asemenea, o singură pană.

## 9. PROIECTAREA FORMEI ŞI GENERAREA MODELELOR ÎN CATIA ALE PARTURILOR SUBANSAMBLELOR PRINCIPALE

Formele și dimensiunile parturilor se pot identifica în cadrul sbansamblelor și/sau ansamblelor care se vor prezenta în continuare.

## 10. GENERARE SUBANSAMBLE RULMENŢI, ARBORI ŞI ANGRENAJ

Denumirea penei/ Parametrul | Pană paralelă I (tip A) | Pană paralelă II (tip A) | Pană paralelă III (tip A)
d [mm] | ST= 22 dA1 | dA3 r = 50 | dA3 ST = 30
b[mm] | 6 | 14 | 8
h [mm] | 6 | 9 | 7
Mt[Nmm] | Mt1 = 47746.483 | Mt2 = 158757.056 | Mt2 = 158757.056
σas [MPa] | 80 | 115 | 110
lc [mm] | 18.085 | 12.271 | 27.490
l [mm] (STAS) | 25 | 35 | 32
t1 [mm] | 3.5 | 5.5 | 4.0
t2[mm] | 2.8 | 3.8 | 3.3

### 10.1 Generare Subansamble rulmenţi

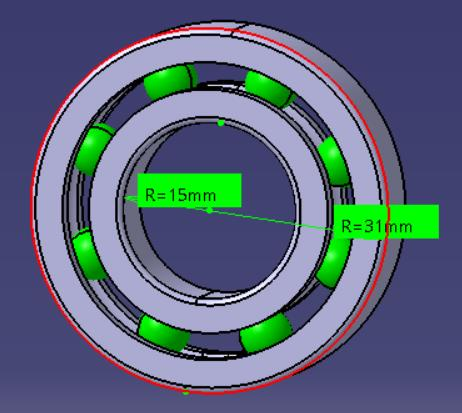
[picture p30: figure]
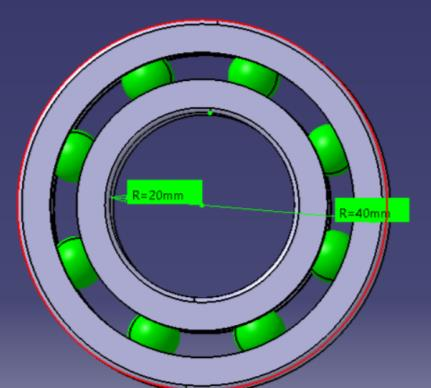
[picture p31: figure]

Rulment radial cu bile I(intrare) | Rulment radial cu bile de II(iesire)

### 10.2 Generare Subansamblu arbore de intrare

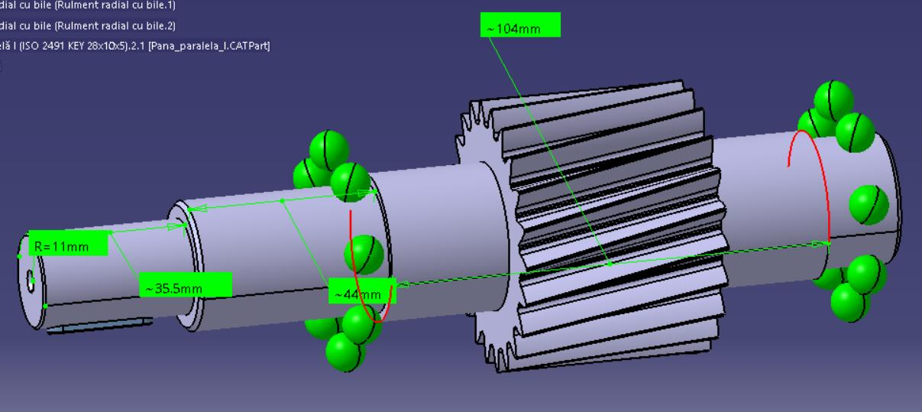
[picture p32: figure]

### 10.3 Generare Subansamblu arbore de ieşire

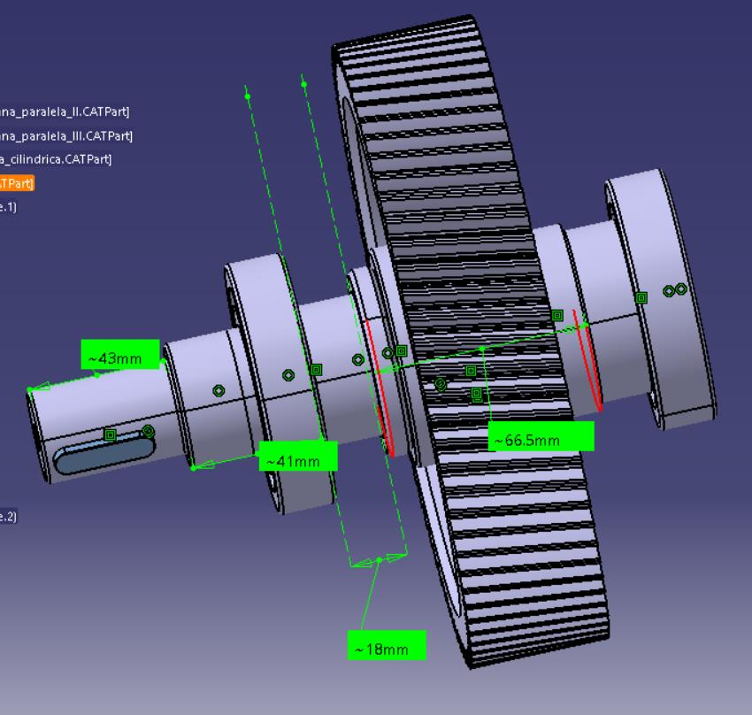
[picture p33: figure]

### 10.4 Generare Subansamblu angrenaj

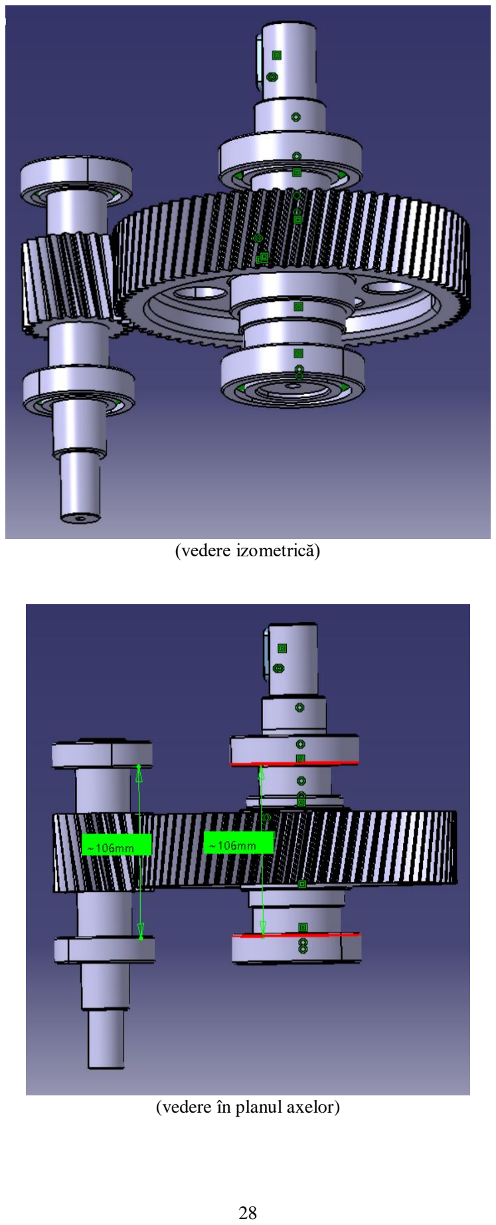
[picture p34: page 28]

(vedere izometrică)

(vedere în planul axelor)

## 11. GENERARE SUBANSAMBLE CARCASE

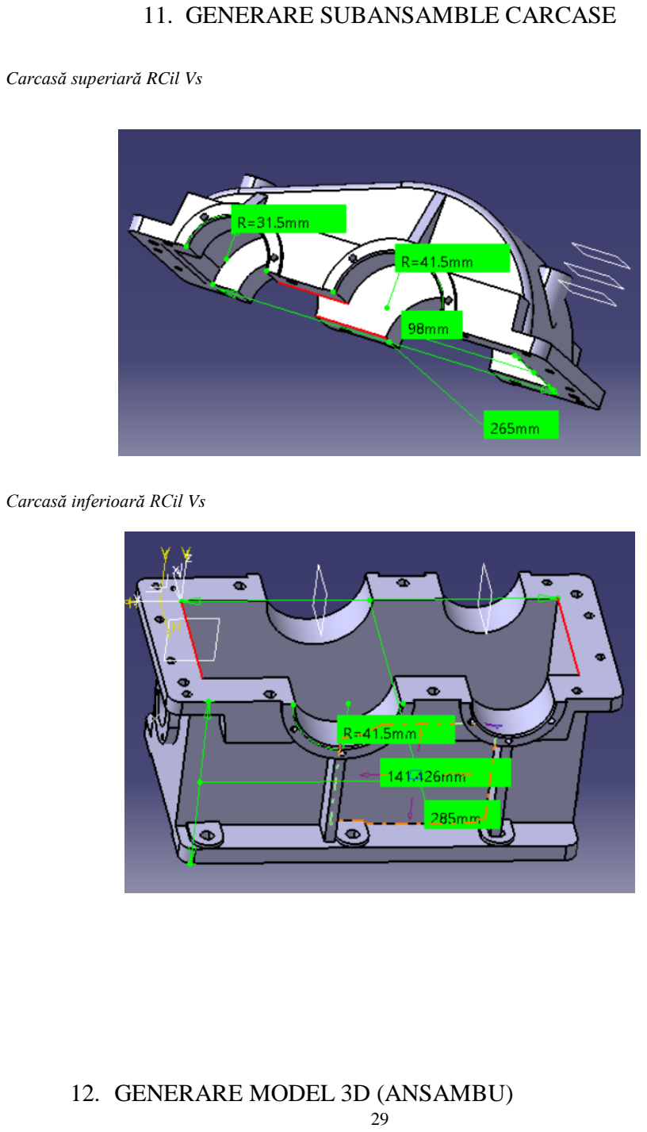
[picture p35: page 29]

Carcasă superiară RCil Vs

Carcasă inferioară RCil Vs

## 12. GENERARE MODEL 3D (ANSAMBU)

Ansamblu RCil Vs

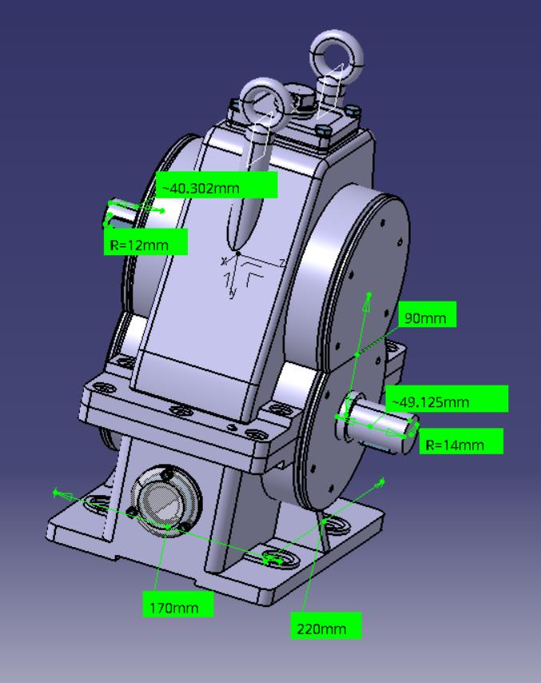
[picture p36: figure]

## 13.VERIFICAREA ARBORILOR

### 13.1 Verificarea arborelui de intrare cu MDESIGN

Schema de încărcare RCil H
xzcd

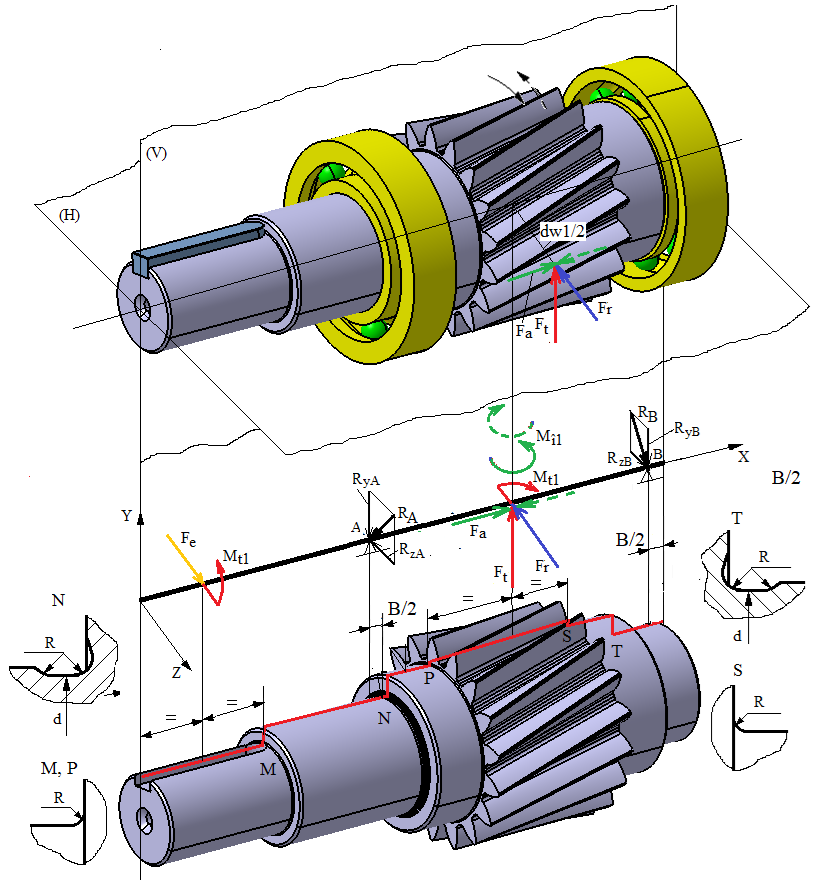
[picture p37: figure]

Schema de încărcare RCil Vj

Schema de încărcare RCil Vs

Date de intrare
Schema arborelui conform schiţei CATIA

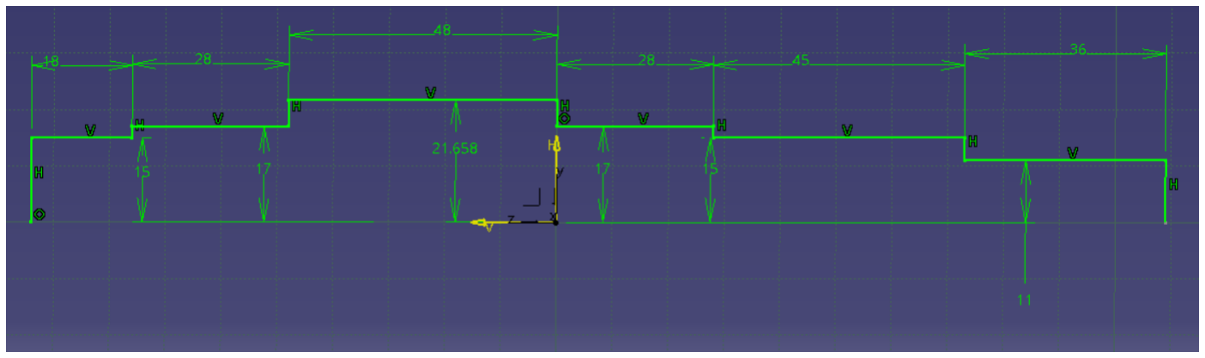
[picture p38: figure]
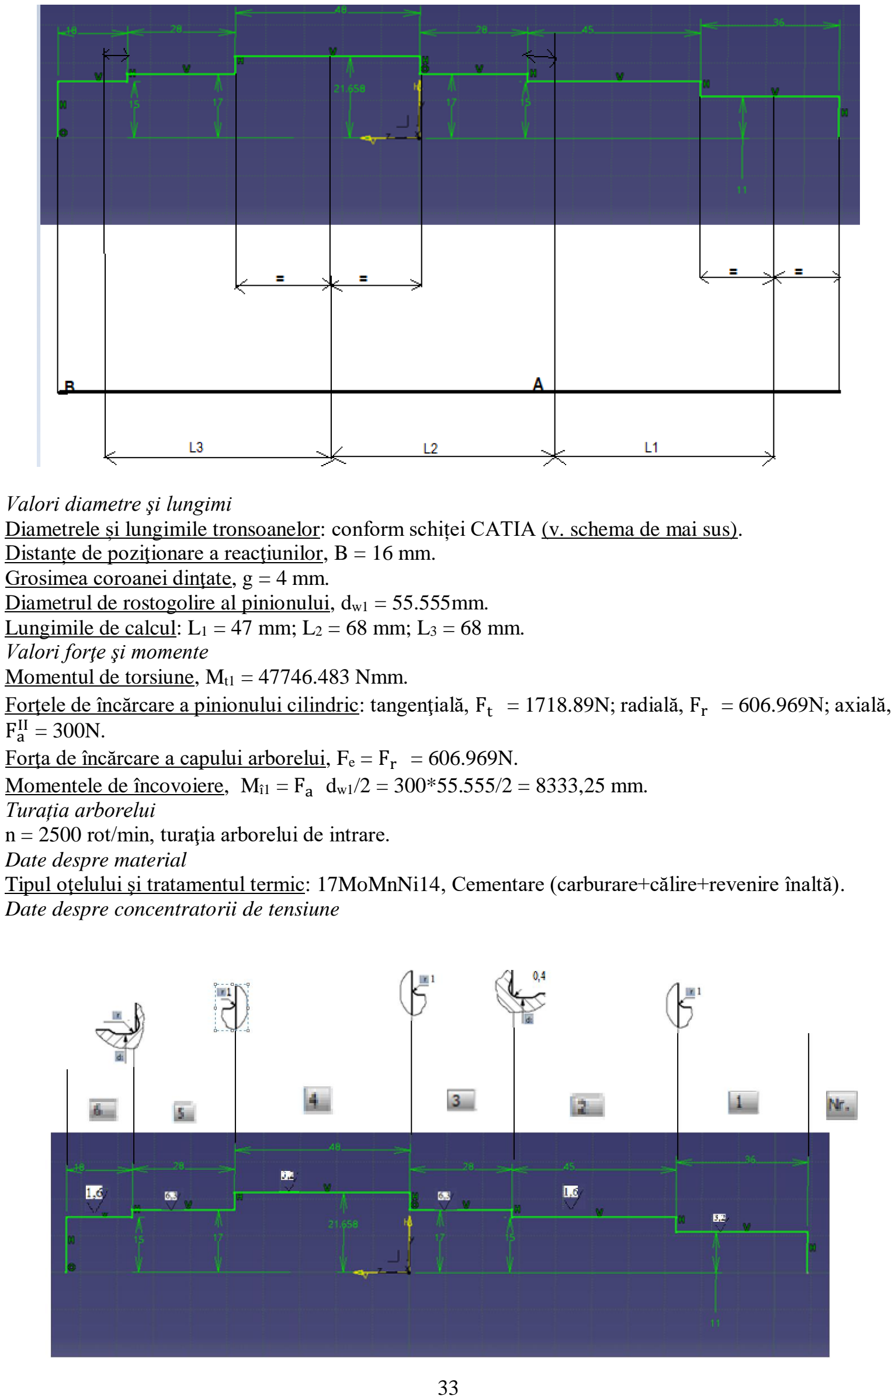
[picture p39: page 33]

Valori diametre şi lungimi
Diametrele și lungimile tronsoanelor: conform schiței CATIA (v. schema de mai sus). Distanțe de poziţionare a reacţiunilor, B = 16 mm.
Grosimea coroanei dinţate, g = 4 mm.
Diametrul de rostogolire al pinionului, dw1 = 55.555mm.
Lungimile de calcul: L1 = 47 mm; L2 = 68 mm; L3 = 68 mm.
Valori forţe şi momente
Momentul de torsiune, Mt1 = 47746.483 Nmm.
Forţele de încărcare a pinionului cilindric: tangenţială, Ft = 1718.89N; radială, Fr = 606.969N; axială, Fa

II = 300N.
Forţa de încărcare a capului arborelui, Fe = Fr = 606.969N.
Momentele de încovoiere, Mî1 = Fa dw1/2 = 300*55.555/2 = 8333,25 mm. Turația arborelui
n = 2500 rot/min, turaţia arborelui de intrare.
Date despre material
Tipul oţelului şi tratamentul termic: 17MoMnNi14, Cementare (carburare+călire+revenire înaltă). Date despre concentratorii de tensiune

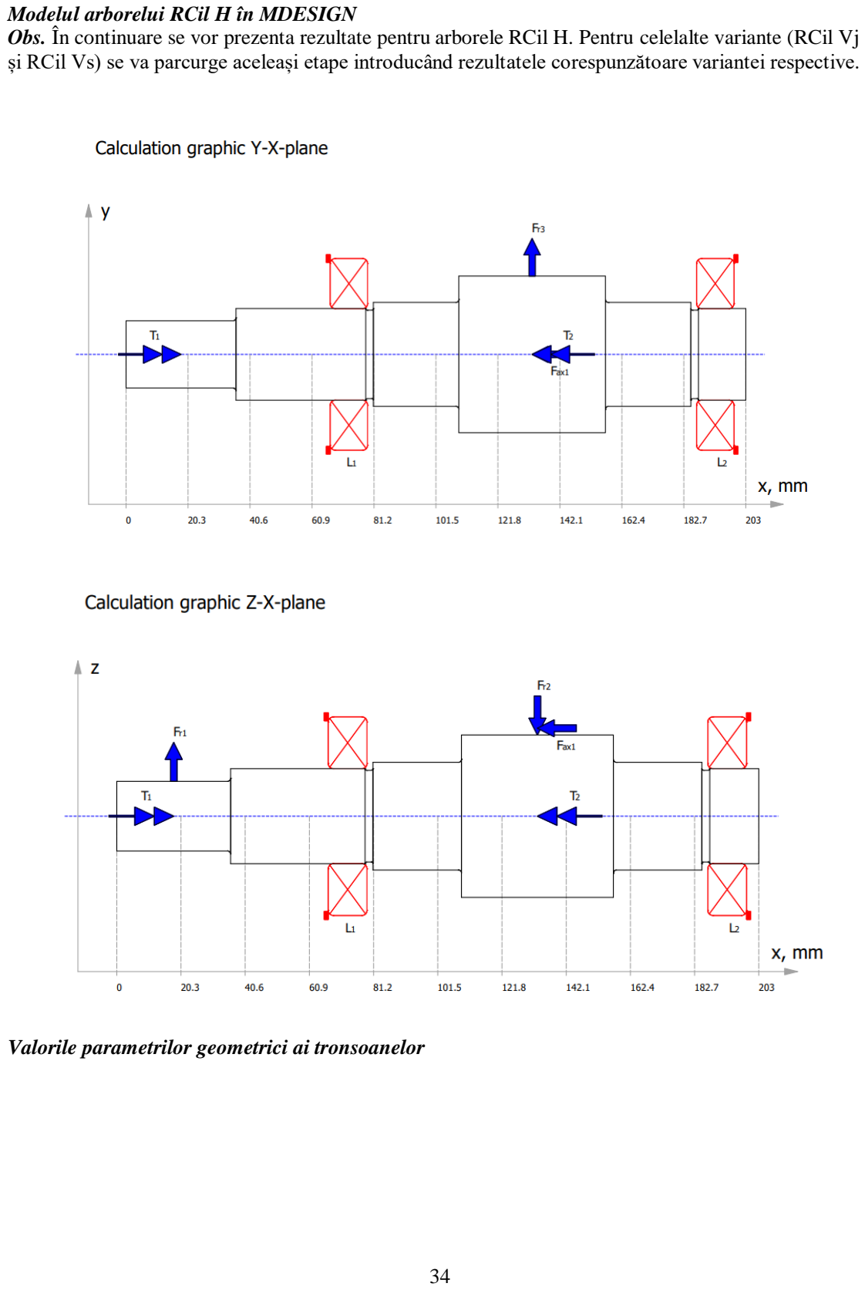
[picture p40: page 34]

Modelul arborelui RCil H în MDESIGN
Obs. În continuare se vor prezenta rezultate pentru arborele RCil H. Pentru celelalte variante (RCil Vj și RCil Vs) se va parcurge aceleași etape introducând rezultatele corespunzătoare variantei respective.

Valorile parametrilor geometrici ai tronsoanelor

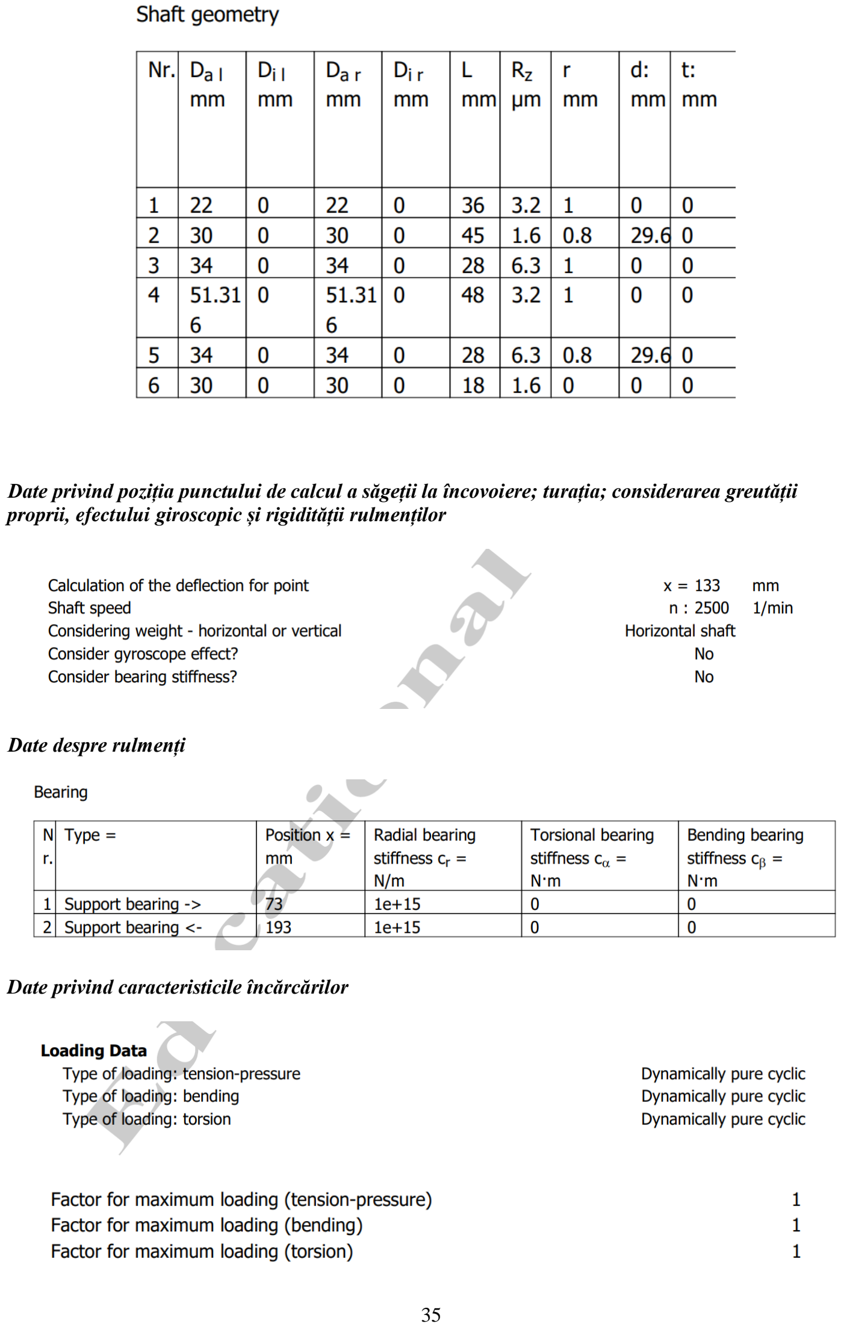
[picture p41: page 35]

Date privind poziția punctului de calcul a săgeții la încovoiere; turația; considerarea greutății proprii, efectului giroscopic și rigidității rulmenților

Date despre rulmenți

Date privind caracteristicile încărcărilor

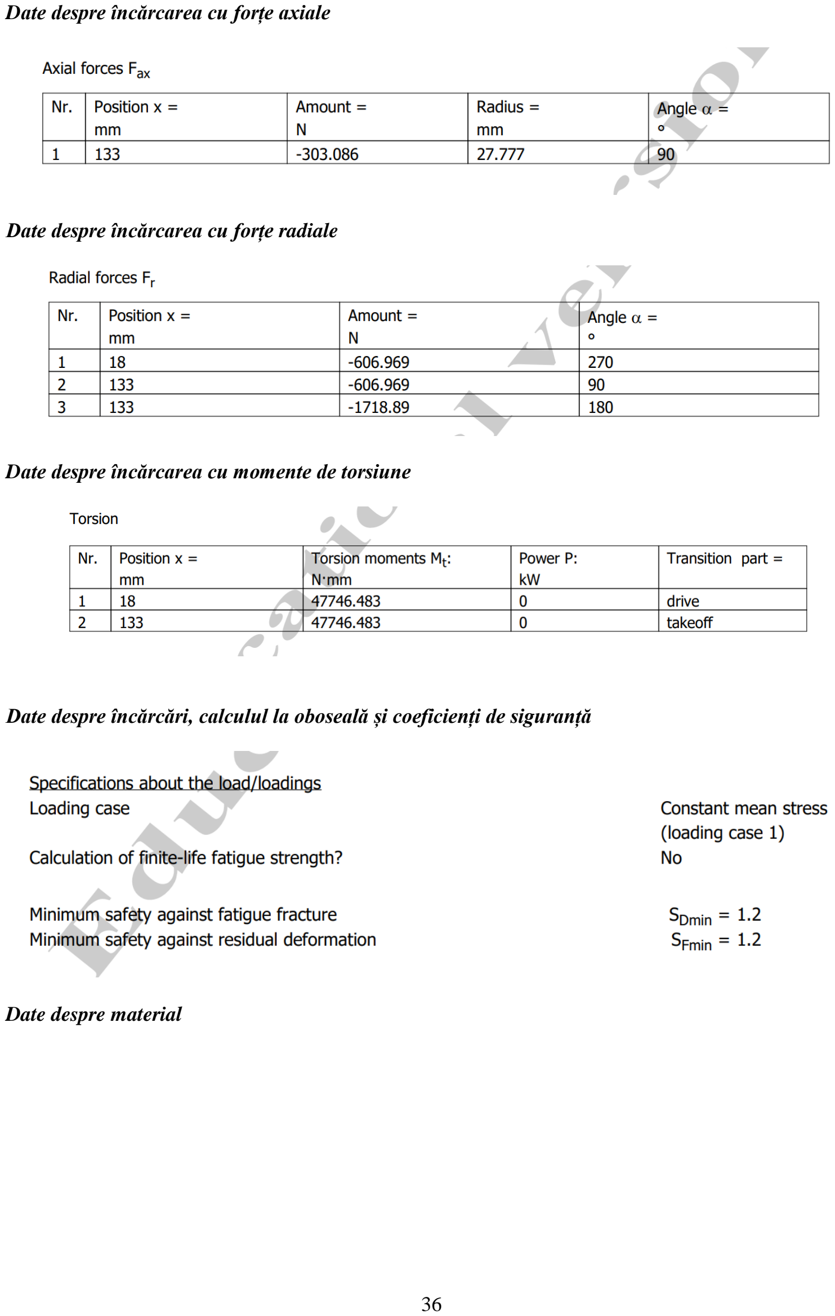
[picture p42: page 36]

Date despre încărcarea cu forțe axiale

Date despre încărcarea cu forțe radiale

Date despre încărcarea cu momente de torsiune

Date despre încărcări, calculul la oboseală și coeficienți de siguranță

Date despre material

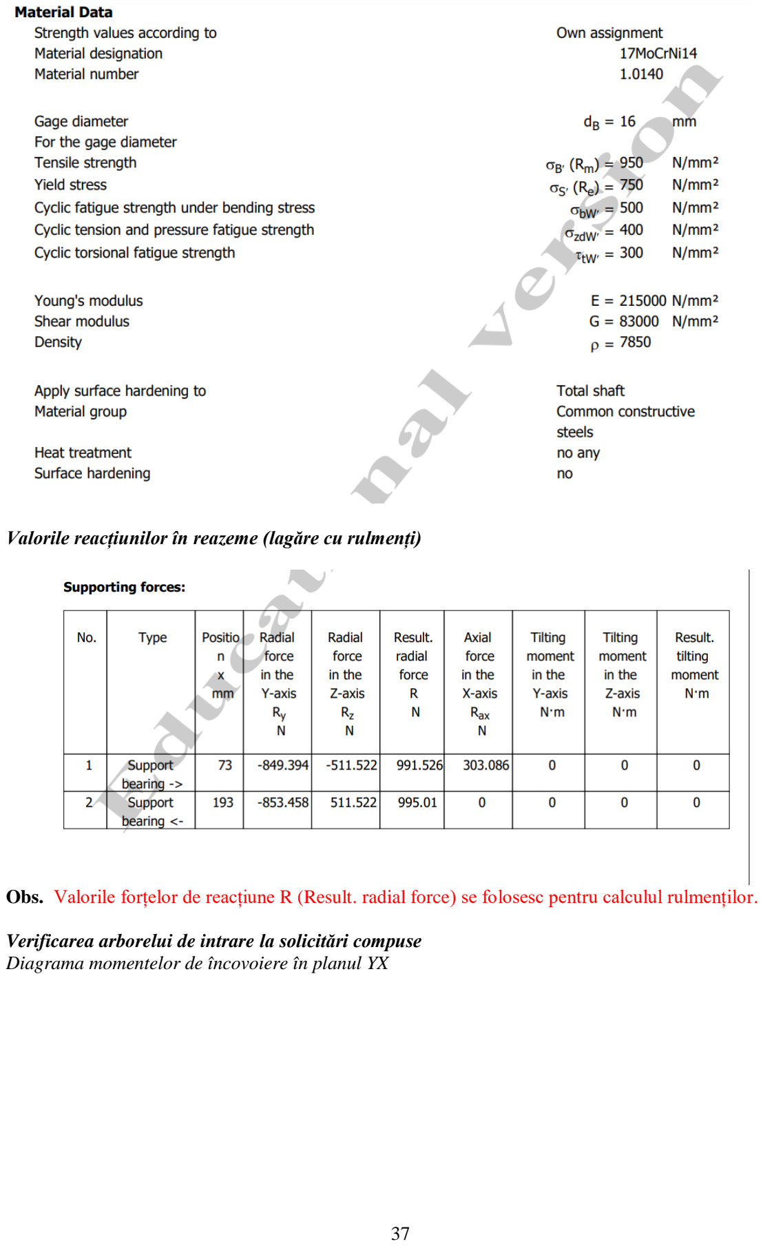
[picture p43: page 37]

Valorile reacțiunilor în reazeme (lagăre cu rulmenți)

Obs. Valorile forțelor de reacțiune R (Result. radial force) se folosesc pentru calculul rulmenților.

Verificarea arborelui de intrare la solicitări compuse
Diagrama momentelor de încovoiere în planul YX

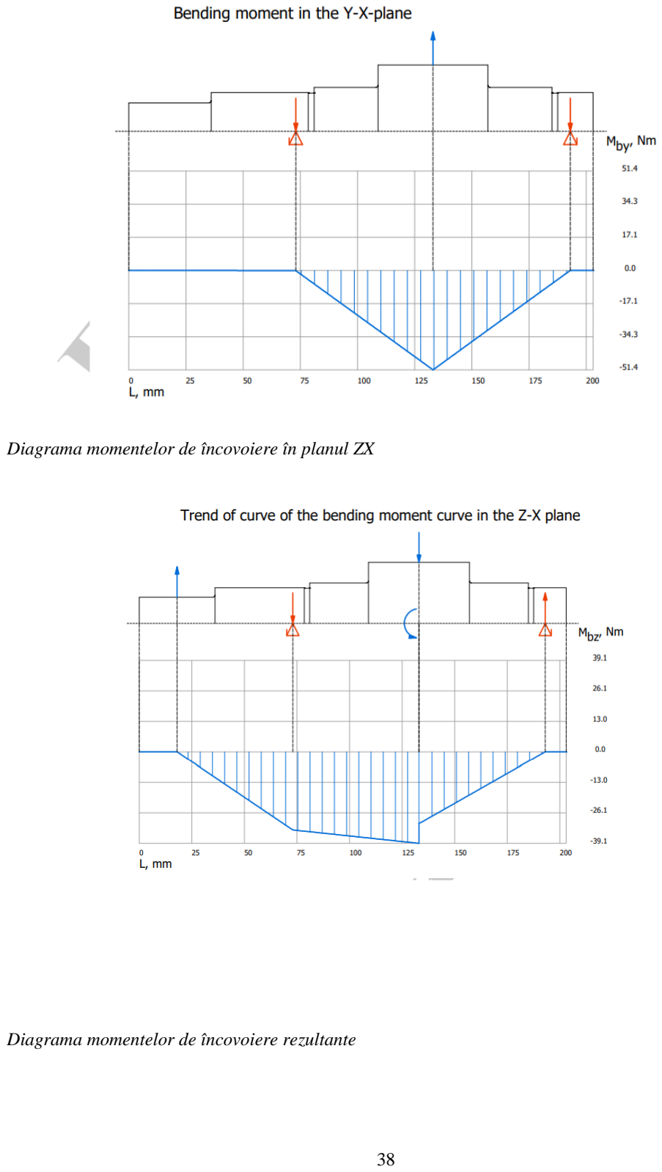
[picture p44: page 38]

Diagrama momentelor de încovoiere în planul ZX

Diagrama momentelor de încovoiere rezultante

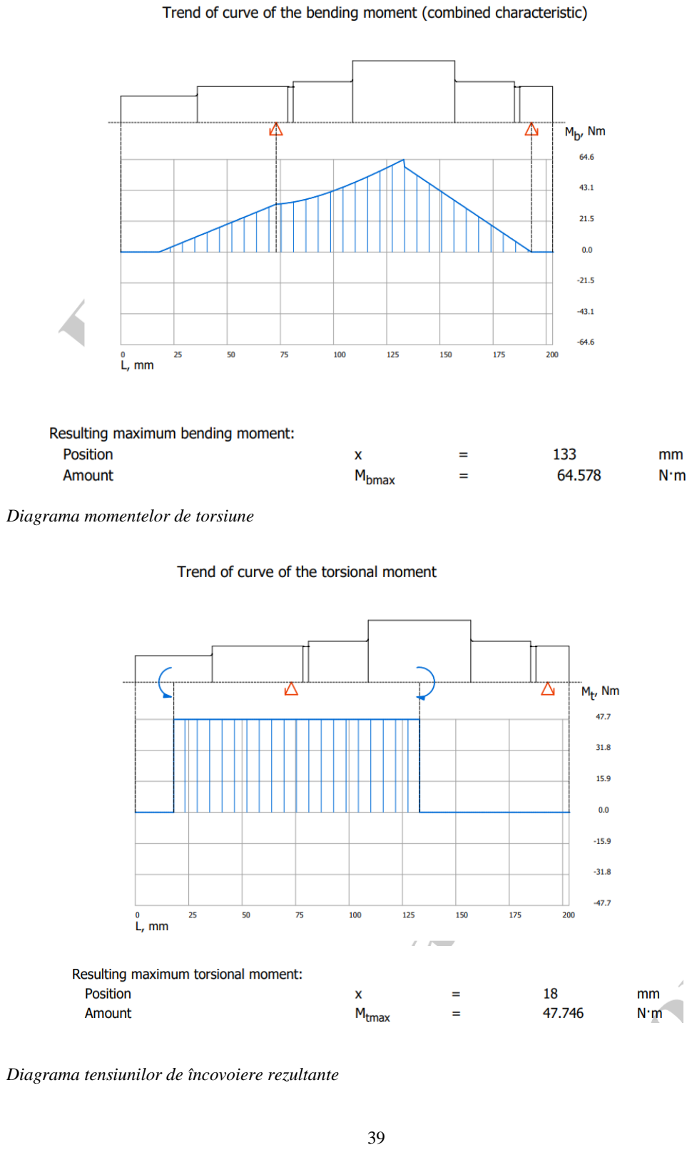
[picture p45: page 39]

Diagrama momentelor de torsiune

Diagrama tensiunilor de încovoiere rezultante

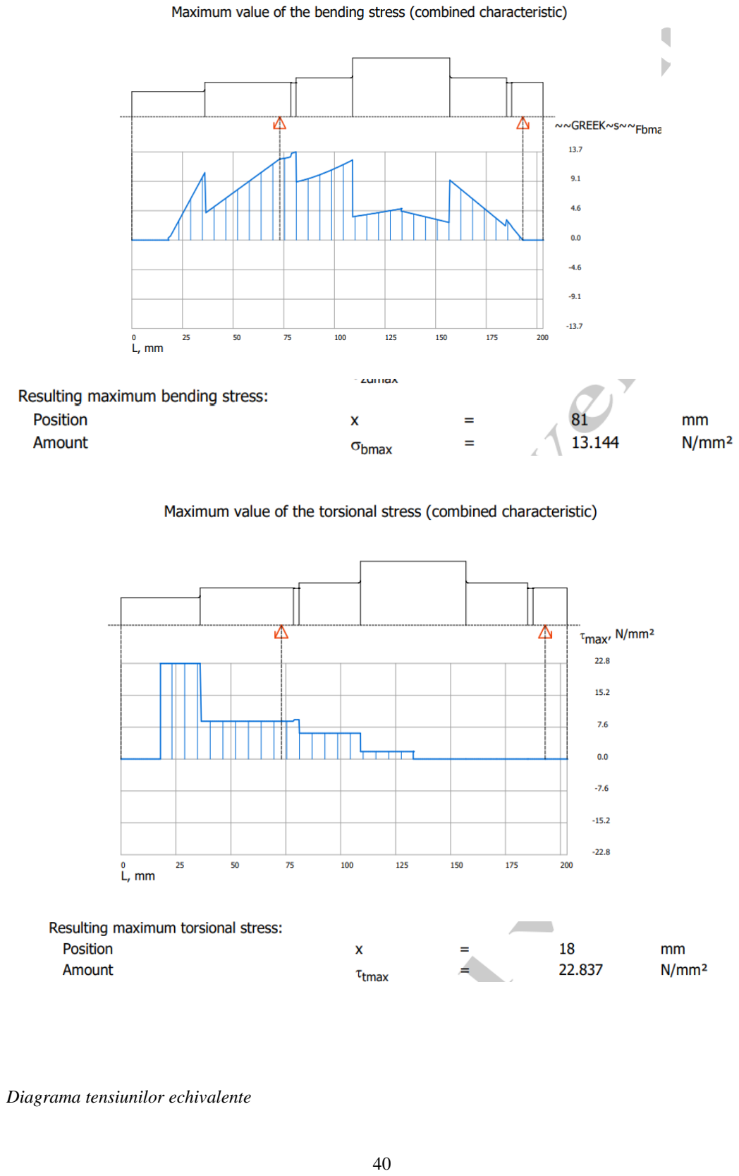
[picture p46: page 40]

Diagrama tensiunilor echivalente

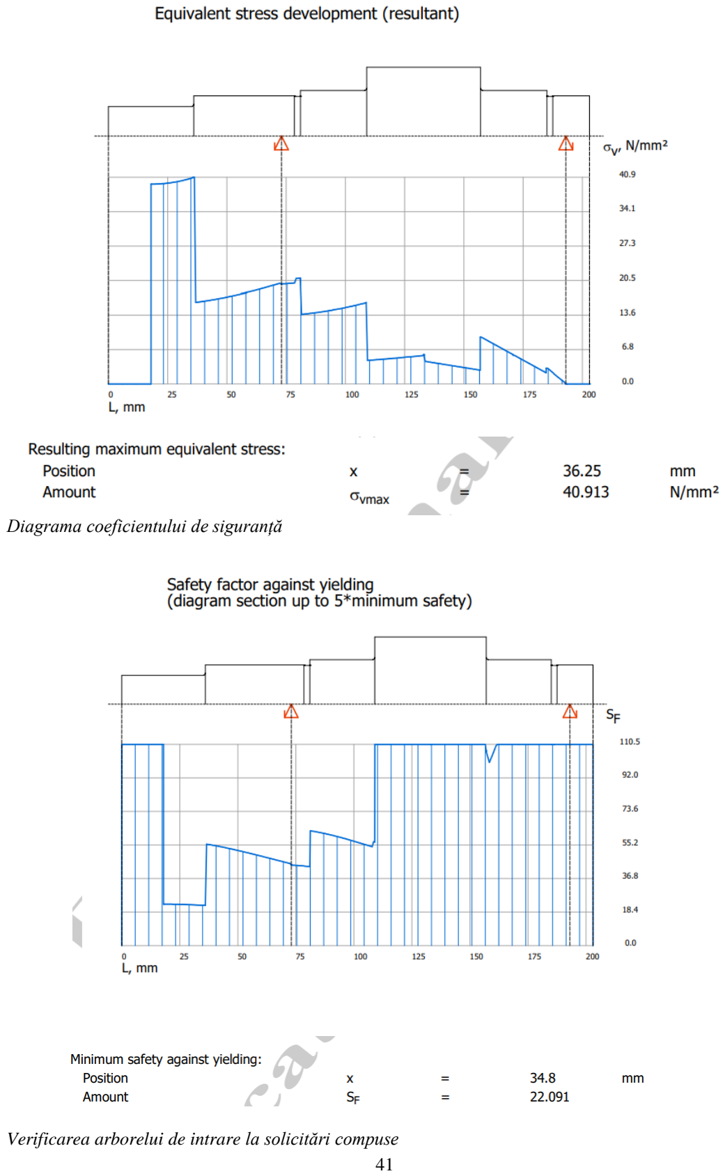
[picture p47: page 41]

Diagrama coeficientului de siguranță

Verificarea arborelui de intrare la solicitări compuse

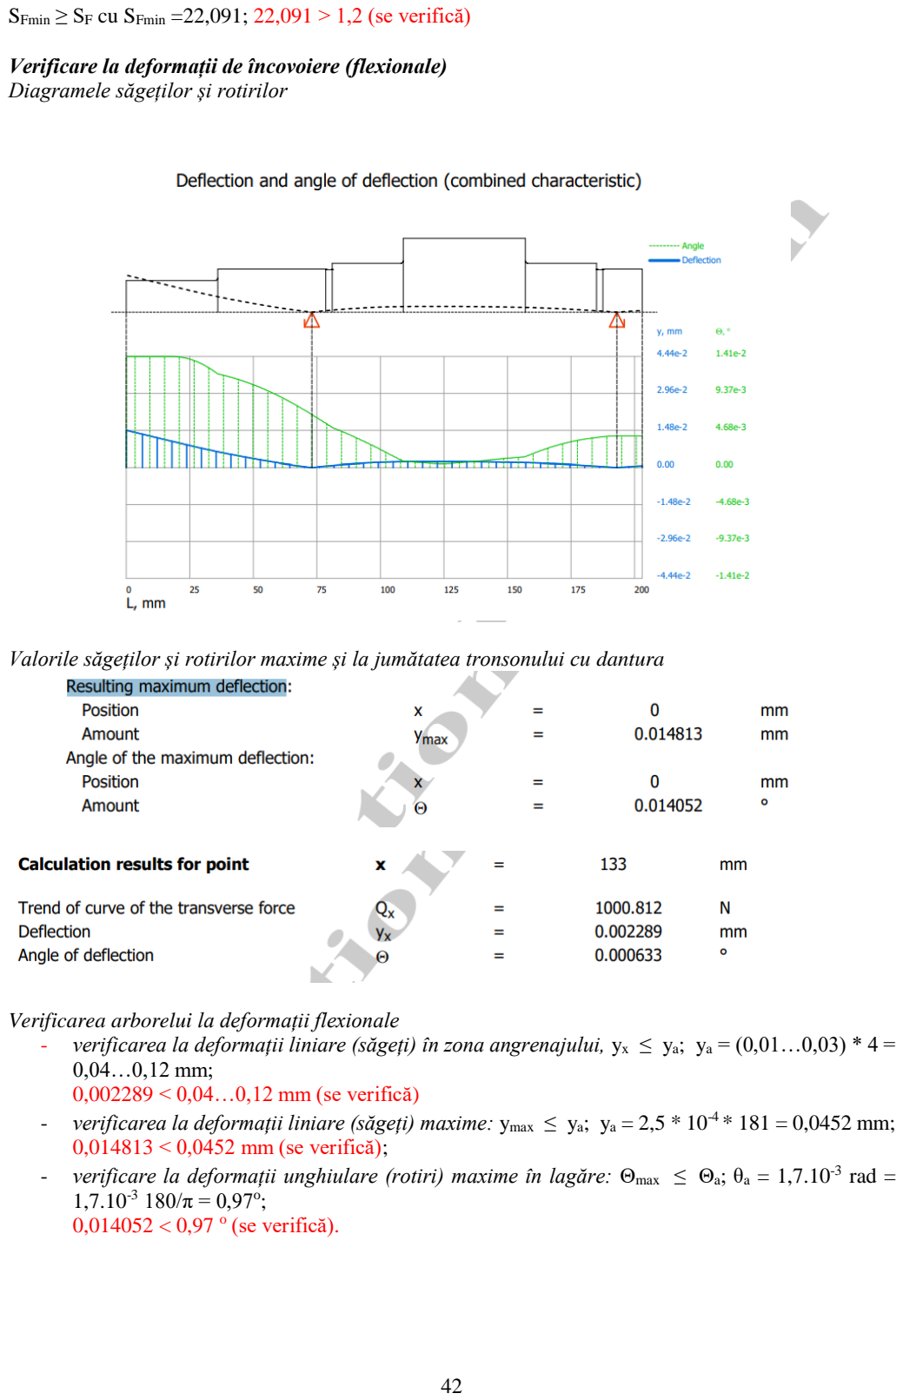
[picture p48: page 42]

SFmin ≥ SF cu SFmin =22,091; 22,091 > 1,2 (se verifică)

Verificare la deformații de încovoiere (flexionale) Diagramele săgeților și rotirilor

Valorile săgeților și rotirilor maxime și la jumătatea tronsonului cu dantura

Verificarea arborelui la deformații flexionale
- verificarea la deformații liniare (săgeți) în zona angrenajului, yx ≤ ya; ya = (0,01…0,03) * 4 = 0,04…0,12 mm;
0,002289 < 0,04…0,12 mm (se verifică)
- verificarea la deformații liniare (săgeți) maxime: ymax ≤ ya; ya = 2,5 * 10⁻⁴ * 181 = 0,0452 mm; 0,014813 < 0,0452 mm (se verifică);
- verificare la deformații unghiulare (rotiri) maxime în lagăre: Θmax ≤ Θa; θa = 1,7.10⁻³
rad =
1,7.10⁻³

180/π = 0,97o
;
0,014052 < 0,97 o
(se verifică).

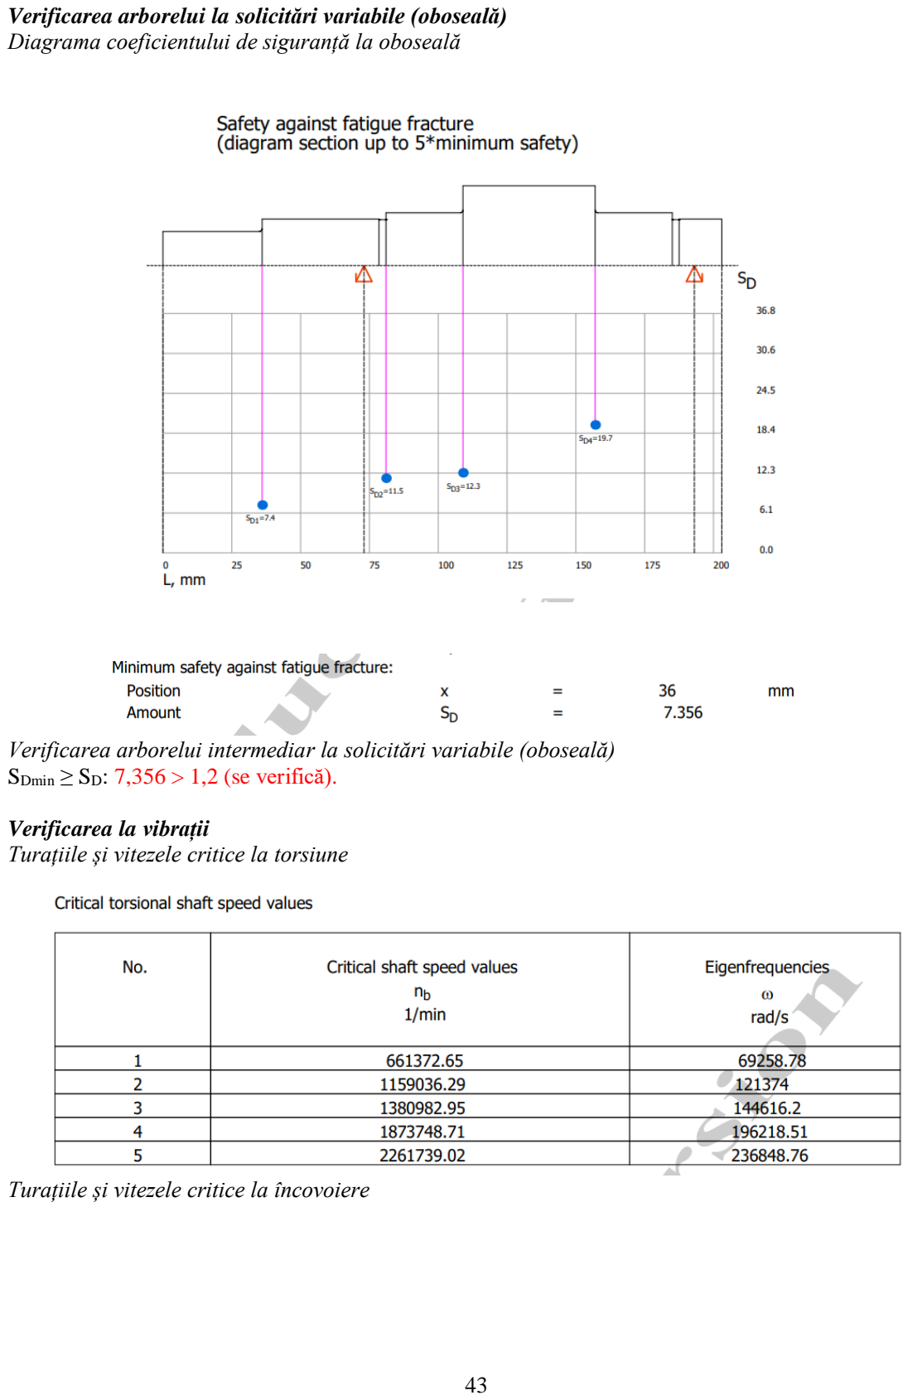
[picture p49: page 43]

Verificarea arborelui la solicitări variabile (oboseală) Diagrama coeficientului de siguranță la oboseală

Verificarea arborelui intermediar la solicitări variabile (oboseală) SDmin ≥ SD: 7,356 > 1,2 (se verifică).

Verificarea la vibrații
Turațiile și vitezele critice la torsiune

Turațiile și vitezele critice la încovoiere

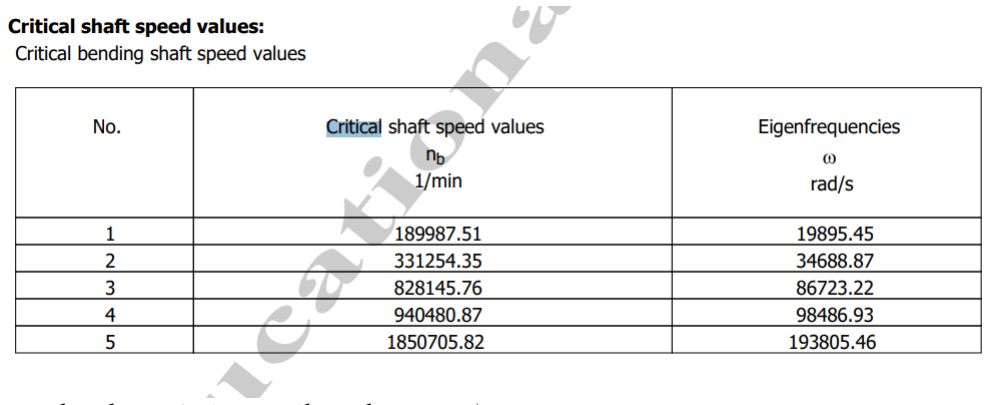
[picture p50: figure]

Verificarea la vibrații (evitarea vibrațiilor critice)
- torsionale, (0…n) ≠ (0,8…1,2)f0:
(0…625) ≠ (0,8…1,2) 661372.65;
(0…625) ≠ (529097.6…793647) rot/min (se verifică).
- flexionale (de încovoiere), (0…n) ≠ (0,8…1,2)f0: (0…625) ≠ (0,8…1,2) 189987.51; (0…625) ≠ (151990.008…227985.012) rot/min (se verifică).

## 14. VERIFICAREA RULMENŢILOR

Obs. În continuare se vor prezenta rezultate pentru verificarea rulmenților radiali cu bile. Pentru cazul rulmenților radial-axiali se vor prezenta etapele corespunzătoare celor din ghidul specific.

### 14.1 Verificarea rulmenţilor radiali pentru arborele de intrare

Schema de încărcare a rulmenţilor radiali

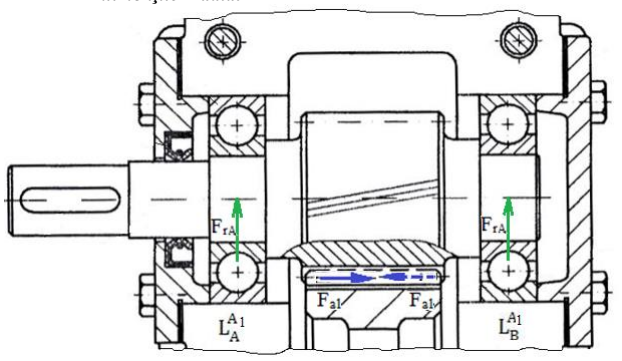
[picture p51: figure]

Date de intrare
Forţele exterioare
- radiale: FrA = 991,526 N, FrB = 995,01 N.
- axiale: Fa1 = ± 300 N; forţa Fa1 în funcţie de sensul de rotaţie poate avea semnul + (de la stânga la dreapta) sau – (de la dreapta la stânga) şi deci, în funcţie de acestea, se impune studiul pentru două cazuri (forța axială încarcă pe rând arborele în ambele sensuri).
Tipul rulmentului şi sarcina (capacitatea) dinamică de bază
Rulment radial cu bile (cod 6303) cu sarcina dinamică de bază C = 13400N, din catalogul pentru rulmenţi.
Factorii de influenţă pentru calcul

Factorul, f0 = 12.3; sarcina statică radială de bază, C0r = 6550 N; pentru f0 Fa

C0r

=

12.3 ∗ 300
= 0,56 şi joc
radial normal (CN) rezultă factorii de influenţă: e = 0,24, X = 0,56, Y = 1.8. Turaţia arborelui
Rulmenţii se rotesc cu turaţia arborelui de intrare, n = n1 = 2500 rot/min.
Durata de funcţionare,
Durata de funcţionare a rulmenţilor este egală cu cea impusă RCil, Lh imp = 12000 ore

Sarcinile dinamice echivalente și rulmentul cel mai încărcat
Pentru rulmentul din lagărul LA

A1

Fa1

FrA

=

300
991,526

= 0,302 > e = 0,24,
sarcina dinamică echivalentă,
PA = X FrA + Y Fa1 = 0,56 * 991,526 + 2 * 300 = 1100.8 N. Pentru rulmentul din lagărul LB

A1

Fa1

FrB

=

300
995.526

= 0,301 > e = 0,24,
sarcina dinamică echivalentă,
PB = X FrB + Y Fa1 = 0,56 * 995.01 + 1,8 * 300 = 1102,7 N. Deoarece, PA > PB, rezultă că rulmentul din lagărul LA

A1
este cel mai încărcat.

Verificarea rulmentului cel mai înărcat
Determinara durabilităţii rulmentului cel mai încărcat LA = (

C
PA

)

p
= (
13400

6826,22)

3
= 1803,75 milioane de rotaţii,

Determinara duratei de funcţionare a rulmentului cel mai încărcat

LhA =

LA10⁶

n1 60

=

1803,75 . 10⁶

2500 . 60

= 12025 ore.

Verificarea rulmentului cel mai încărcat
LhA > Lh imp; 12025> 12000 ( se verifică).

## 15. MODELAREA ŞI GENERAREA DESENULUI DE ANSAMBLU

Obs. În continuare, se prezentă desenul RCil H. În cazul altei variante se va prezenta desenul corespunzător.

| Desen de ansamblu RCil H

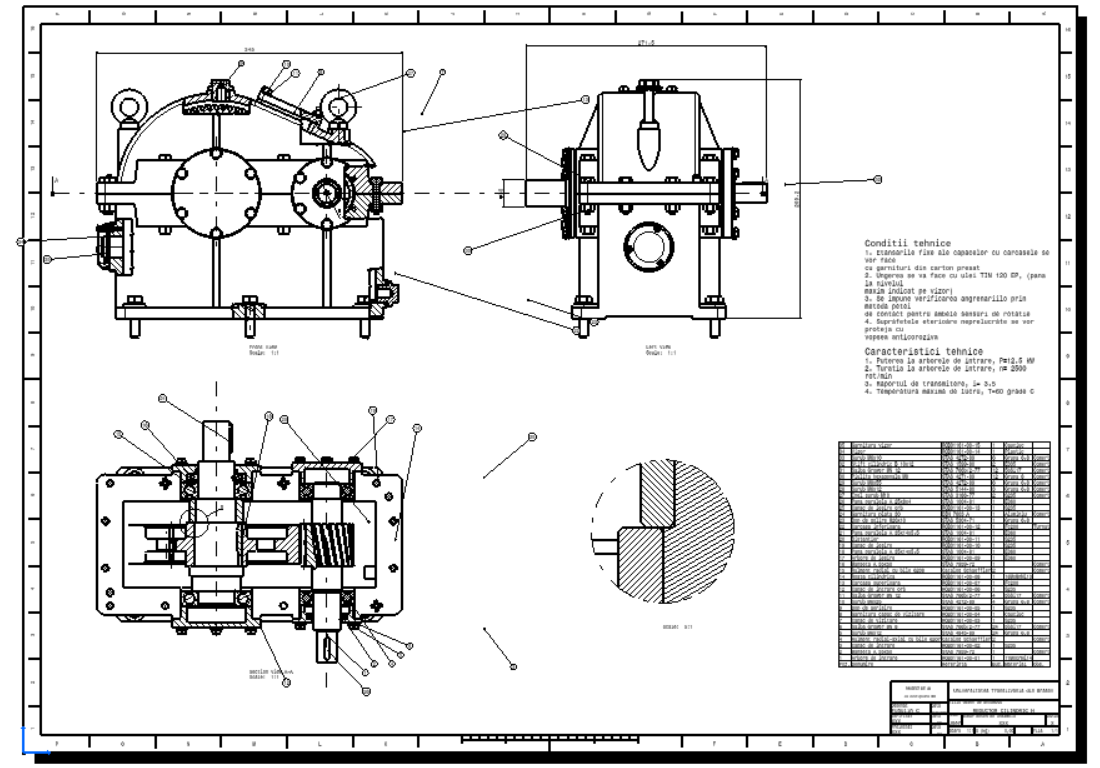
[picture p52: figure]

## 16. MODELAREA ŞI GENERAREA DESENELOR DE EXECUŢIE

Obs. În continuare, se prezentă desenele pentru arborele de intrare cu pinion cilindic, roata dințată cilindrică și arborele de ieșire din componența RCil H. În cazul unui proiect personalizat se vor prezenta desenele indicate în tema de proiectare.

Desen de execuţie Arbore de intrare cu pinion cilindric

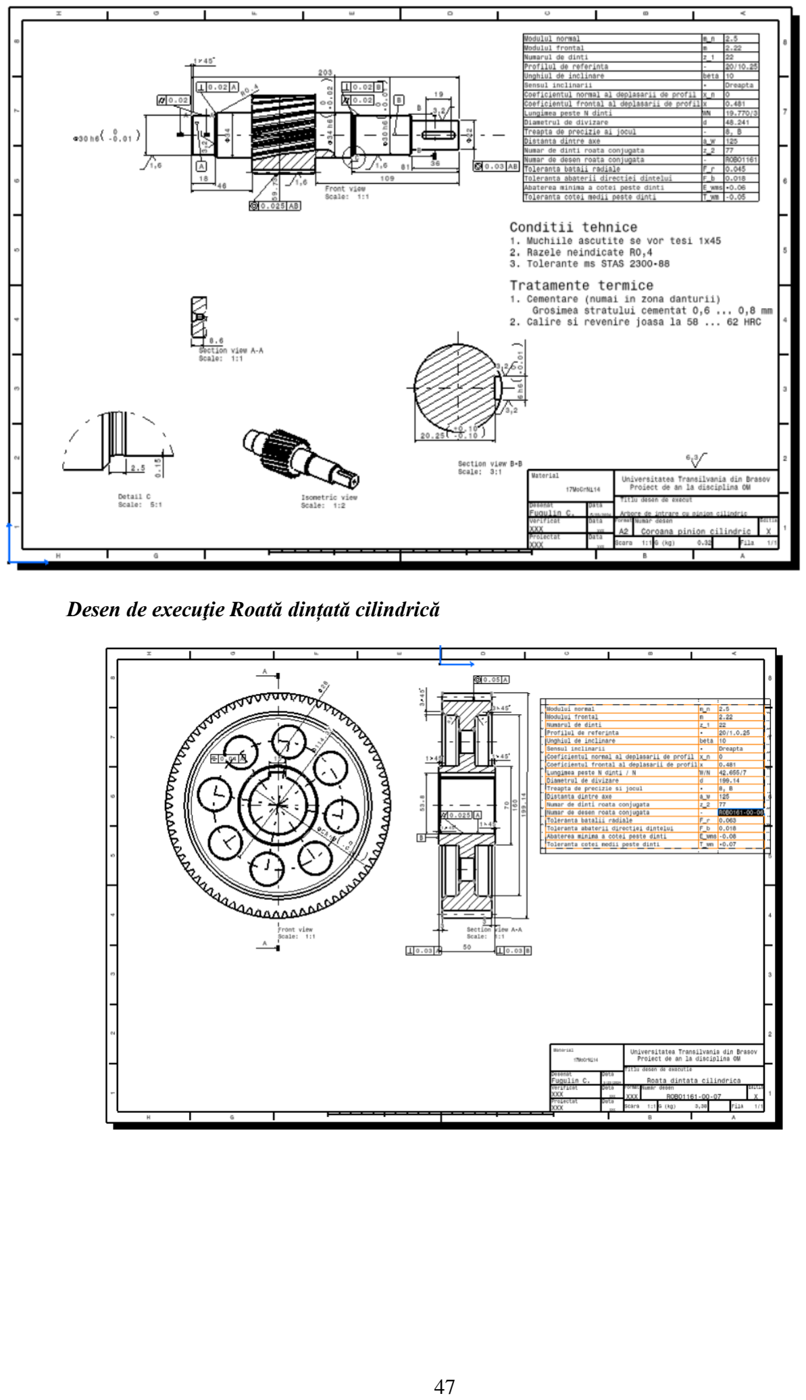
[picture p53: page 47]

Desen de execuţie Roată dințată cilindrică

## BIBLIOGRAFIE

1. Jula, A. ş.a. Organe de maşini, vol. I,II. Universitatea din Braşov, 1986, 1989.
2. Mogan, Gh. ş.a. Organe de maşini. Teorie-Proiectare-Aplicații, Ed Universității Transilvania din Braşov, 2012 (format electronic: www.mg.rrv.ro, user name: student; password: mogan).
3. Moldovean, Gh. ş.a. Angrenaje cilindrice şi conice. Calcul şi construcţie. Ed. LuxLibris, Braşov, 2001.
4. Moldovean, Gh. ş.a. Angrenaje cilindrice şi conice. Metodici de proiectare. Ed. LuxLibris, Braşov, 2002.
5. Rădulescu, C. Organe de maşini, vol. I, II, III. Universitatea Transilvania din Braşov, 1985.
6. *** Culegere de norme şi extrase din standarde pentru proiectarea elementelor componente ale maşinilor, vol. I. şi II. Universitatea din Braşov, 1984.
