fclaudiu19/industrial-gearbox-design/(list of files, cad)

Other CAD files:
CAD/Ansamblu H.CATProduct
CAD/CATPart.10.1.1 Rulment radial Iesire.CATPart
CAD/CATPart.10.1.1 Rulment radial Intrare.CATPart
CAD/CATPart.11.1.1.1 Generare Carcasa inferioara H (1).CATPart
CAD/CATPart.11.1.1.1 Generare Carcasa inferioara H.CATPart
CAD/CATPart.11.1.2.1 Generare Carcasa superioara H (1).CATPart
CAD/CATPart.11.2.1.1 Buson de aerisire.CATPart
CAD/CATPart.11.2.1.2 Dop de golire.CATPart
CAD/CATPart.11.2.1.3 Garnitura plata de etansare vizor.CATPart
CAD/CATPart.11.2.1.3 Garnitura plata de etansare.CATPart
CAD/CATPart.11.2.2.1 Vizor nivel de ulei.CATPart
CAD/CATPart.11.2.3.1 Capac de vizitare.CATPart
CAD/CATPart.11.2.3.2 Garnitura capac de vizitare.CATPart
CAD/CATPart.11.2.4.1 Inel de ridicare.CATPart
CAD/CATPart.11.2.5.2 Saiba Grower Carcase.CATPart
CAD/CATPart.11.2.5.2 Saiba Grower Rulment.CATPart
CAD/CATPart.11.2.5.2 Saiba Grower VizitareMN6.CATPart
CAD/CATPart.11.2.5.2 Saiba Grower Vizot.CATPart
CAD/CATPart.11.2.5.2 Saiba Grower jos.CATPart
CAD/CATPart.11.2.5.2 Saiba Grower.CATPart
CAD/CATPart.12.2.1.1 Garnitura manseta de rotatie.CATPart
CAD/CATPart.3.3.3.2.1 Model dinti in angrenare (1).CATPart
CAD/CATPart.3.3.3.2.2 Model pentru simulare si verificare angrenare.CATPart
CAD/CATPart.5.1.3 Arbore cu pinion cilindric.CATPart
CAD/CATPart.5.1.5 Baza cu rulmenti.CATPart
CAD/CATPart.9.1 Coroana pinion cilindric.CATPart
CAD/CATPart.9.3_Arbore_de_iesire.CATPart
CAD/CATPart.9.4_Roata_cilindrica.CATPart
CAD/CATPart.9.5_Distantier_I_II_III.CATPart
CAD/CAtPart.5.1.4 Arbore cu roata cilindrica.CATPart
CAD/Capac_I.CATPart
CAD/Capac_II.CATPart
CAD/Capac_III.CATPart
CAD/Capac_IV.CATPart
CAD/Garnitura manseta de rotatie Capac II.CATPart
CAD/Garnitura manseta de rotatie Capac IV.CATPart
CAD/ISO_4017 SCREW M10 PRINDERE JOS.CATPart
CAD/ISO_4017 SCREW M6 CAPAC RULMENT.CATPart
CAD/ISO_4017 SCREW M6 CAPAC VIZITARE.CATPart
CAD/ISO_4017 SCREW M8 LUNG iNTRE CARCASE.CATPart
CAD/ISO_4017 SCREW M8 SCURT INTRE CARCASE.CATPart
CAD/ISO_4034 NUT M8 CARCASE.CATPart
CAD/Model cinematic RCil.CATProduct
CAD/Pana_paralela_I.CATPart
CAD/Pana_paralela_II.CATPart
CAD/Pana_paralela_III.CATPart
CAD/Saiba capac vizor.CATPart
CAD/Stift.CATPart
CAD/Subansamblu angrenaj.CATProduct
CAD/Subansamblu arbore de iesire.CATProduct
CAD/Subansamblu arbore de intrare.CATProduct
CAD/Subansamblu carcasa inferioara.CATProduct
CAD/Sumansamblu carcasa superioara.CATProduct
CAD/Surub hexagonal vizor.CATPart
